Yousuf-Eslam/HELAL73_Robot/README.md

The project is documented in this video: https://www.youtube.com/watch?v=oLMEJUjaXHw&t=226s
