Yousuf-Eslam/HELAL73_Robot/Renders/Screenshot_1.png

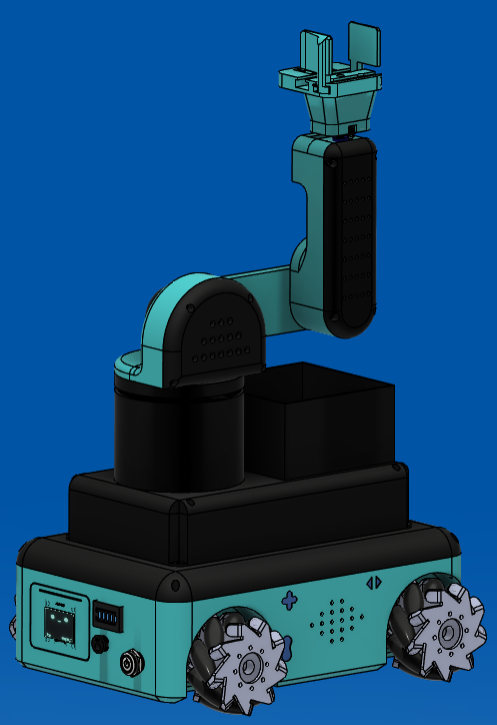
Renders/Screenshot_1.png
