Yousuf-Eslam/HELAL73_Robot/Renders/Screenshot_2.png

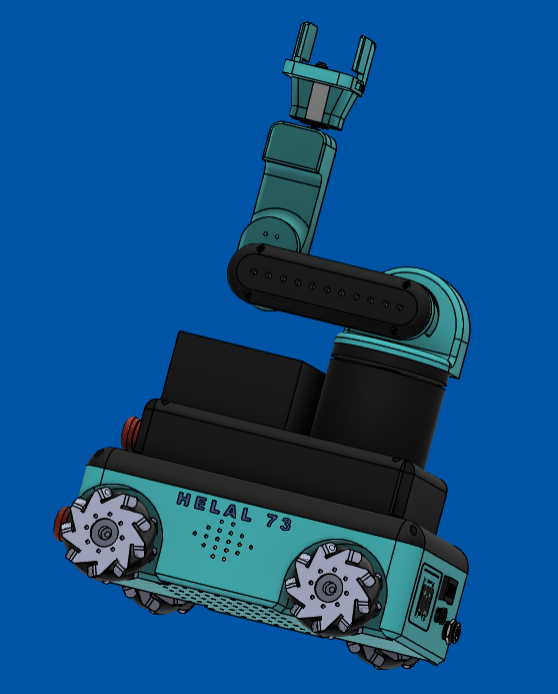
Renders/Screenshot_2.png
