Yousuf-Eslam/HELAL73_Robot/Renders/Screenshot_3.png

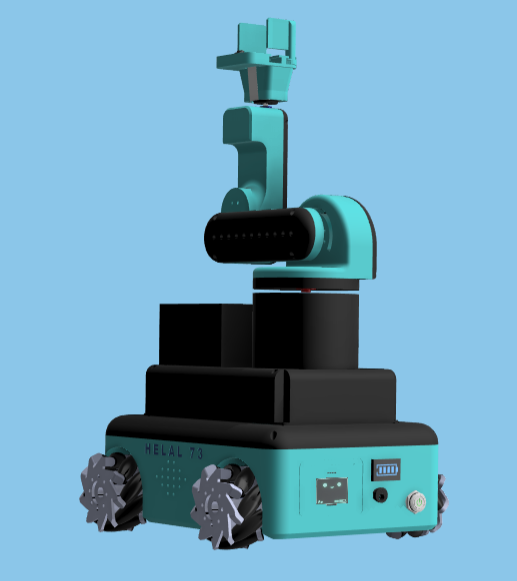
Renders/Screenshot_3.png
