Yousuf-Eslam/HELAL73_Robot/Renders/Screenshot_4.png

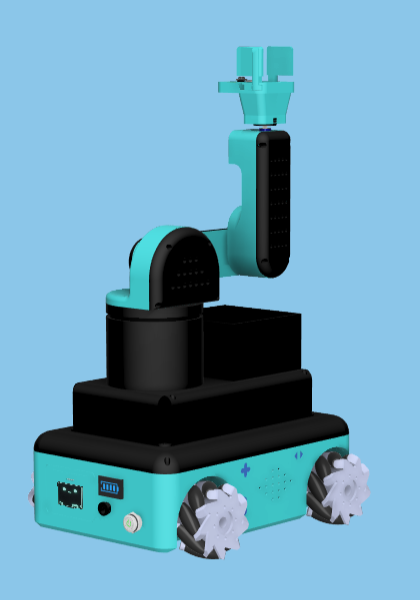
Renders/Screenshot_4.png
