Yousuf-Eslam/HELAL73_Robot/Renders/Screenshot_5.png

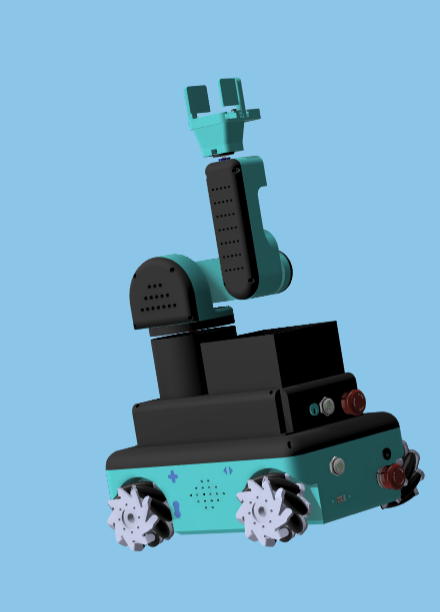
Renders/Screenshot_5.png
