Yousuf-Eslam/HELAL73_Robot/3D_Printing_Files/Exports 9-5/Main_Part.stl

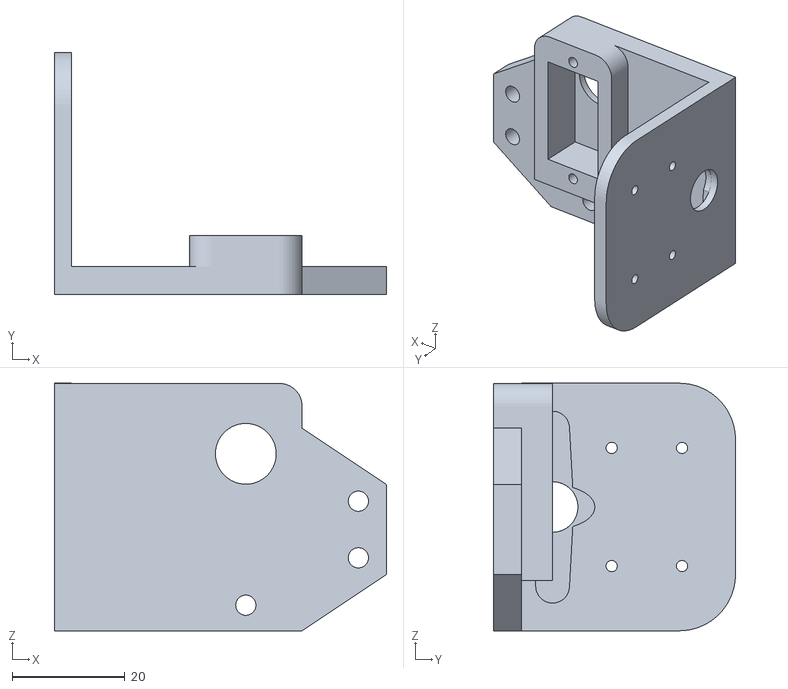
[picture p26: CAD file, 2026-09-05]
3D_Printing_Files/Exports 9-5/Main_Part.stl
59.0 x 43.0 x 44.0
