Yousuf-Eslam/HELAL73_Robot/Arm_URDF_Files/Gripper Assembly.step

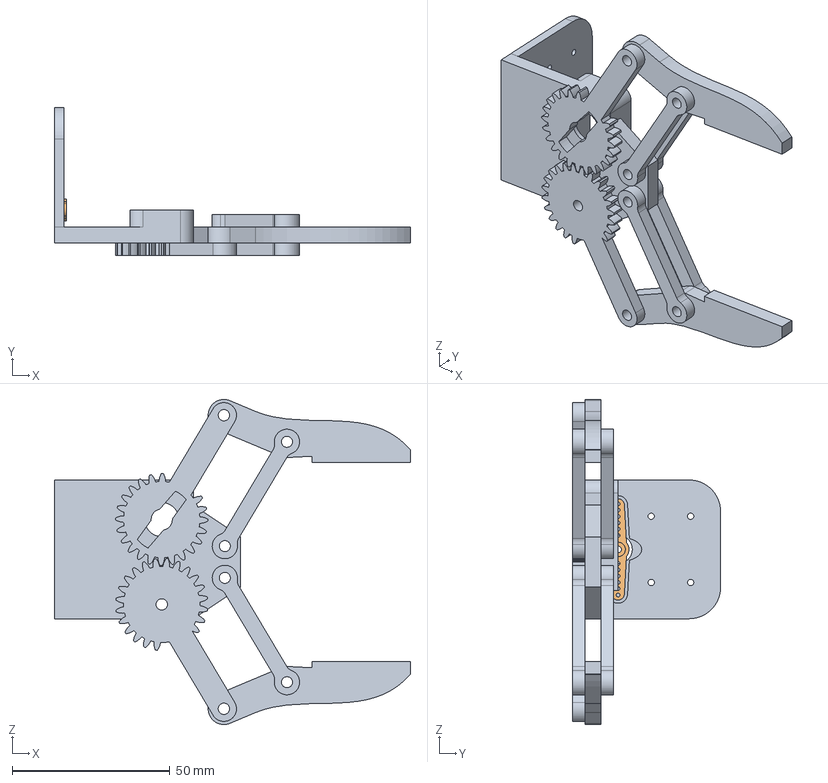
[picture p27: CAD file, 2026-09-05]
Arm_URDF_Files/Gripper Assembly.step
112.9 x 47.0 x 103.1 mm
