Yousuf-Eslam/HELAL73_Robot/3D_Printing_Files/Cover Sketch.dxf

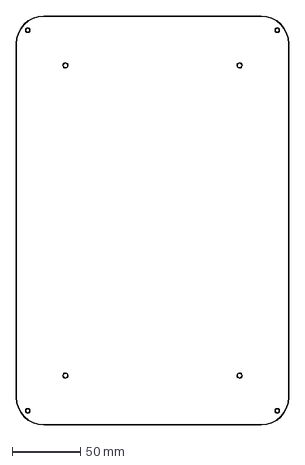
[picture p28: CAD file, 2026-09-05]
3D_Printing_Files/Cover Sketch.dxf
200.0 x 300.0 mm
