Yousuf-Eslam/HELAL73_Robot/3D_Printing_Files/Exports 18-4/Rover Body(Light Blue).stl

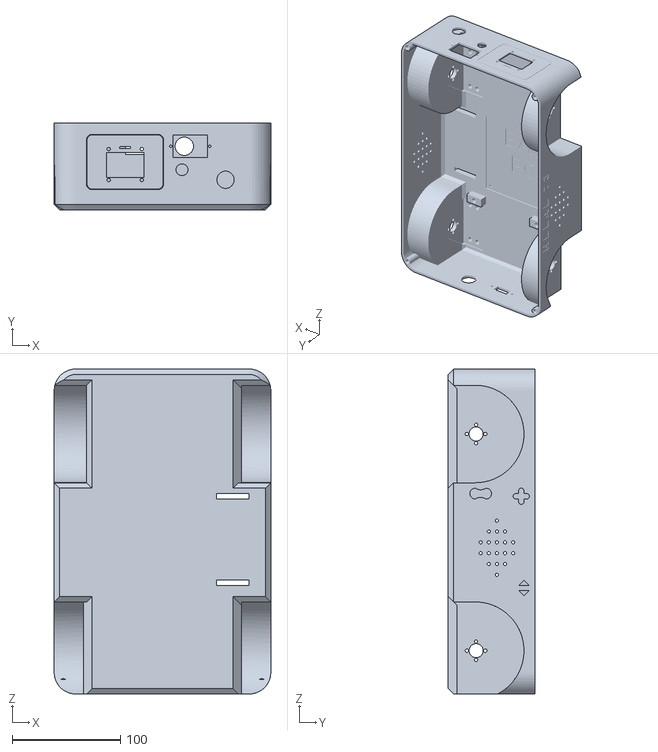
[picture p29: CAD file, 2026-09-05]
3D_Printing_Files/Exports 18-4/Rover Body(Light Blue).stl
200.0 x 80.0 x 300.0
