Yousuf-Eslam/HELAL73_Robot/3D_Printing_Files/Exports 21 -4/DC Motor Mount.stl

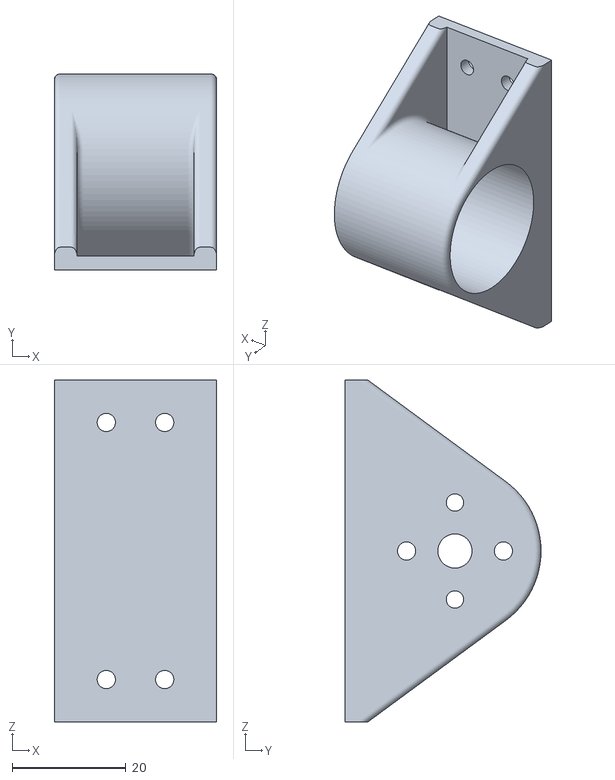
[picture p30: CAD file, 2026-09-05]
3D_Printing_Files/Exports 21 -4/DC Motor Mount.stl
28.5 x 34.4 x 60.0
