Yousuf-Eslam/HELAL73_Robot/3D_Printing_Files/Exports 7-5/Arm_Base_Joint_Connector_Modified.stl

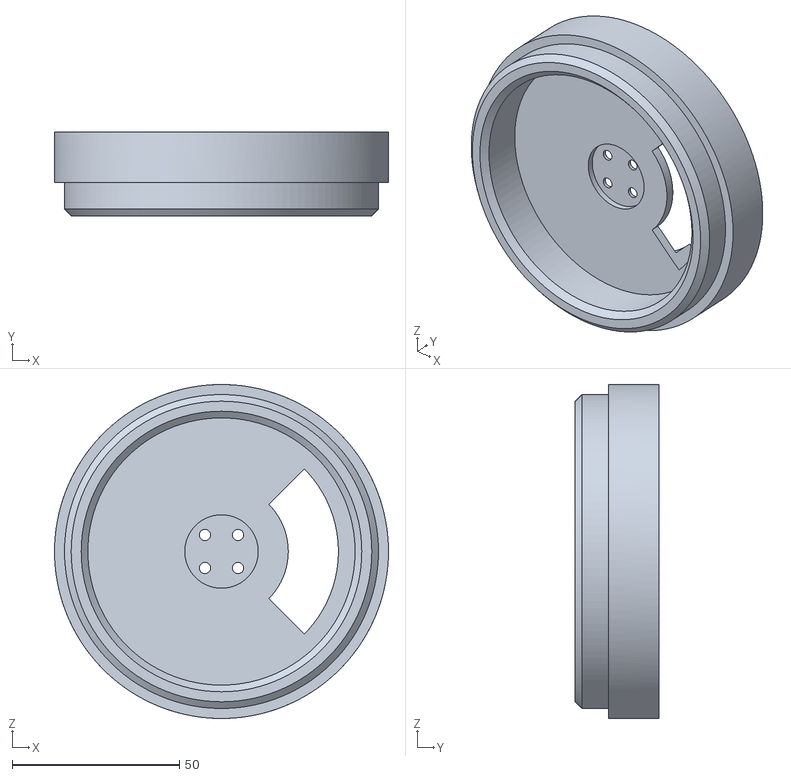
[picture p31: CAD file, 2026-09-05]
3D_Printing_Files/Exports 7-5/Arm_Base_Joint_Connector_Modified.stl
100.0 x 25.0 x 100.0
