Yousuf-Eslam/HELAL73_Robot/3D_Printing_Files/Exports 7-5/Gripper/Gear3.stl

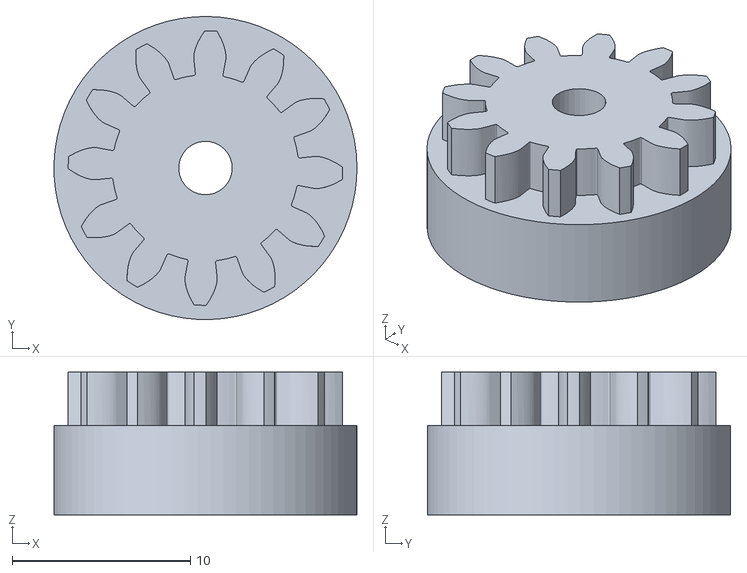
[picture p32: CAD file, 2026-09-05]
3D_Printing_Files/Exports 7-5/Gripper/Gear3.stl
17.0 x 17.0 x 8.00
