Yousuf-Eslam/HELAL73_Robot/3D_Printing_Files/Gripper/Grip Connector Step.stl

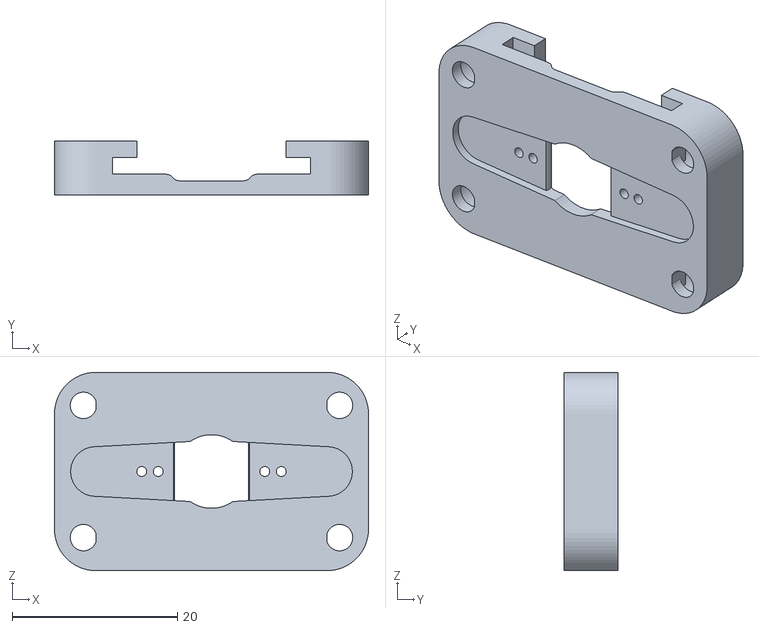
[picture p33: CAD file, 2026-09-05]
3D_Printing_Files/Gripper/Grip Connector Step.stl
38.0 x 6.50 x 24.0
