Yousuf-Eslam/HELAL73_Robot/3D_Printing_Files/Joints/Joint 3 Cover.step

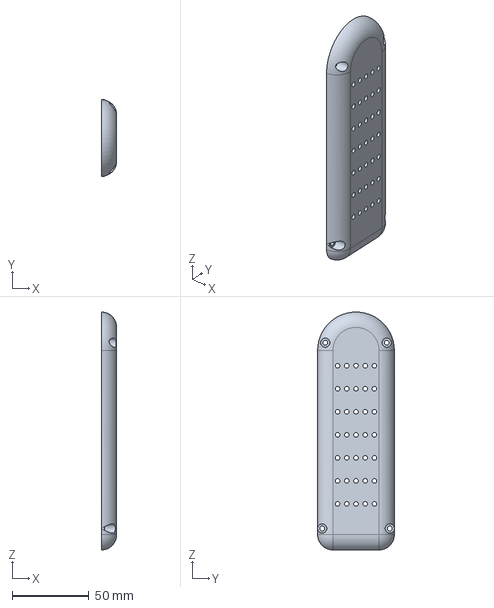
[picture p34: CAD file, 2026-09-05]
3D_Printing_Files/Joints/Joint 3 Cover.step
10.0 x 50.0 x 155.0 mm
