Yousuf-Eslam/HELAL73_Robot/3D_Printing_Files/STL Pack 2/Part 7 - Joint 1 Cover.stl

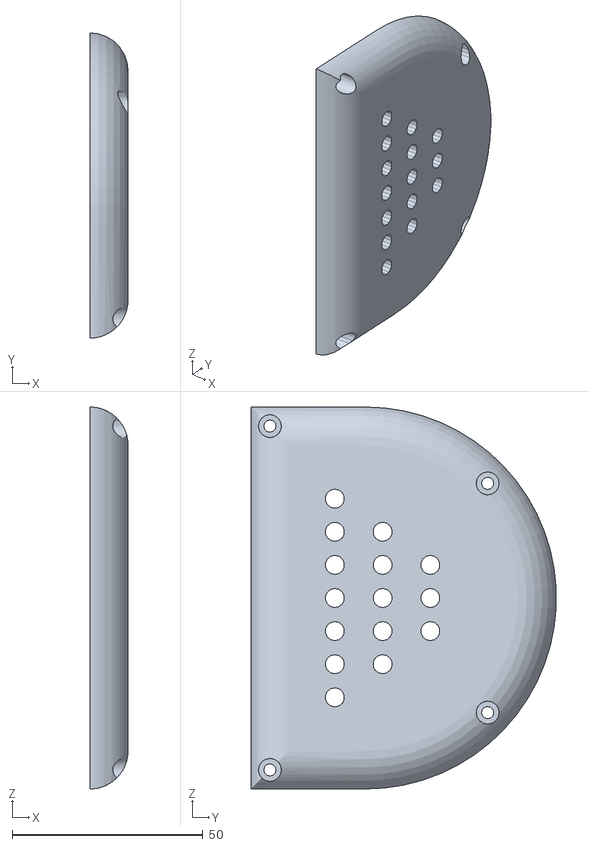
[picture p35: CAD file, 2026-09-05]
3D_Printing_Files/STL Pack 2/Part 7 - Joint 1 Cover.stl
10.0 x 79.9 x 100.0
