Yousuf-Eslam/HELAL73_Robot/Arm_URDF_Files/Beta_V7/Assembly.SLDASM/meshes/base_link.STL

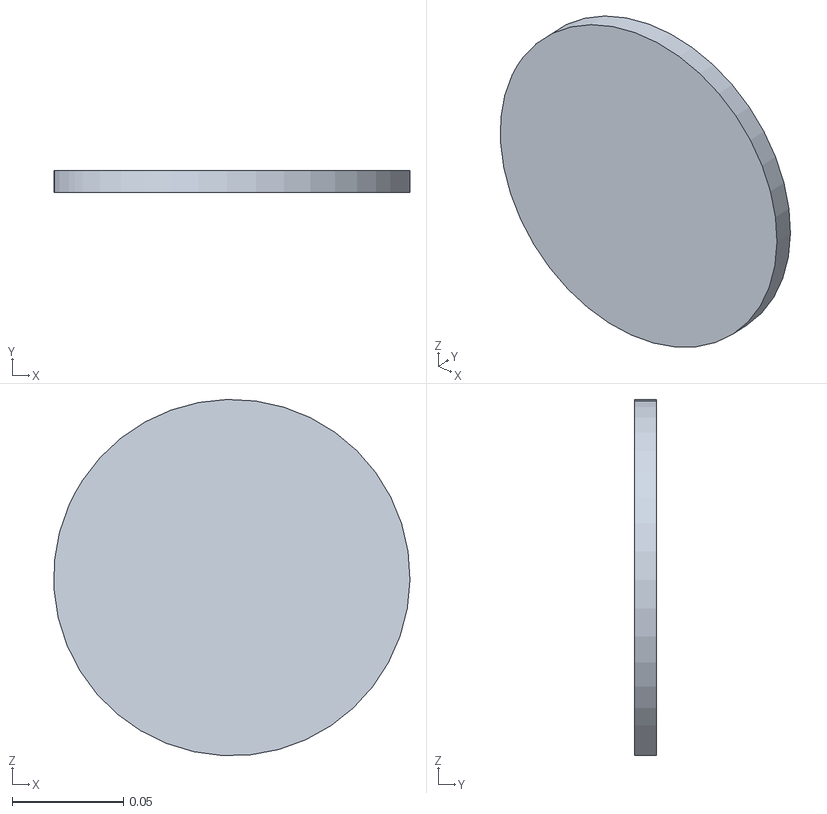
[picture p36: CAD file, 2026-09-05]
Arm_URDF_Files/Beta_V7/Assembly.SLDASM/meshes/base_link.STL
0.16 x 0.01 x 0.16
