Yousuf-Eslam/HELAL73_Robot/Arm_URDF_Files/Joint 3.step

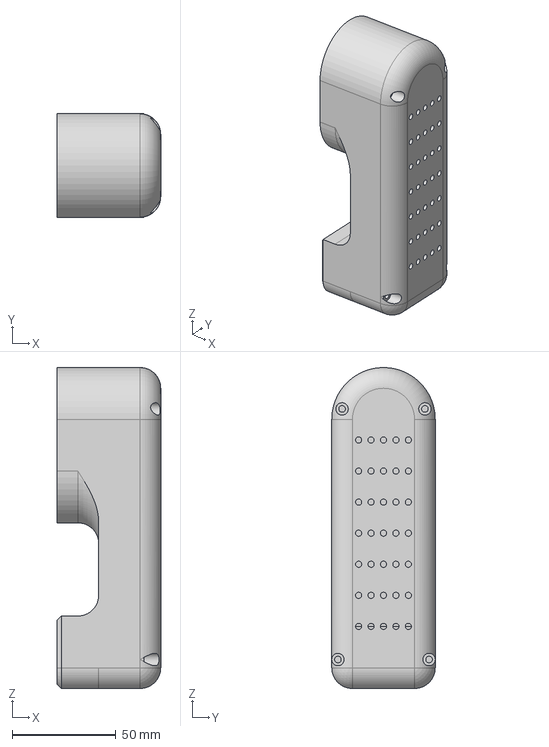
[picture p37: CAD file, 2026-09-05]
Arm_URDF_Files/Joint 3.step
50.0 x 50.0 x 155.0 mm
