Yousuf-Eslam/HELAL73_Robot/Arm_URDF_Files/URDF Assembly/Assembly.SLDASM/meshes/link1.STL

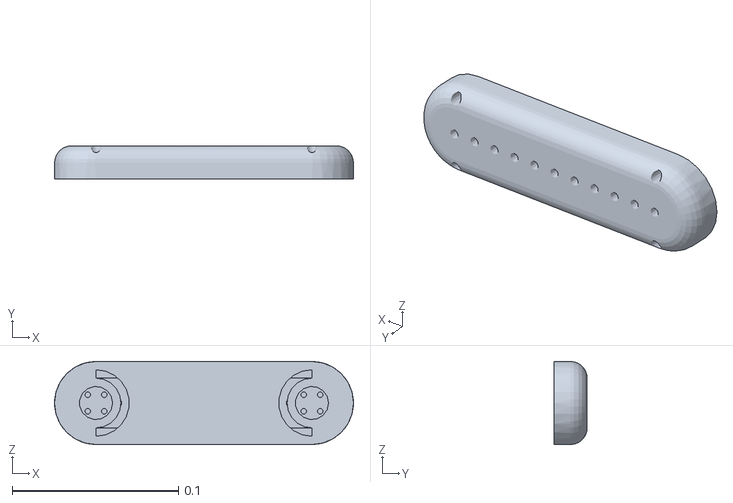
[picture p38: CAD file, 2026-09-05]
Arm_URDF_Files/URDF Assembly/Assembly.SLDASM/meshes/link1.STL
0.18 x 0.02 x 0.05
