Yousuf-Eslam/HELAL73_Robot/3D_Printing_Files/Exports 18-4/Big Gear(Light Blue).stl

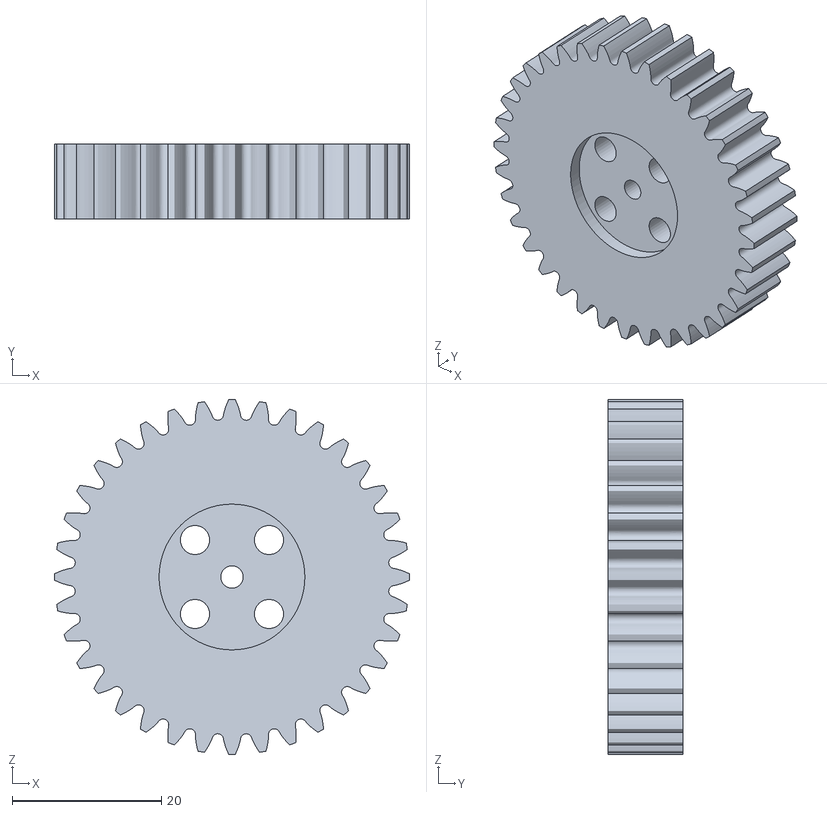
[picture p39: CAD file, 2026-09-05]
3D_Printing_Files/Exports 18-4/Big Gear(Light Blue).stl
47.5 x 10.0 x 47.5
