Yousuf-Eslam/HELAL73_Robot/3D_Printing_Files/Exports 7-5/Gripper/Gear2.stl

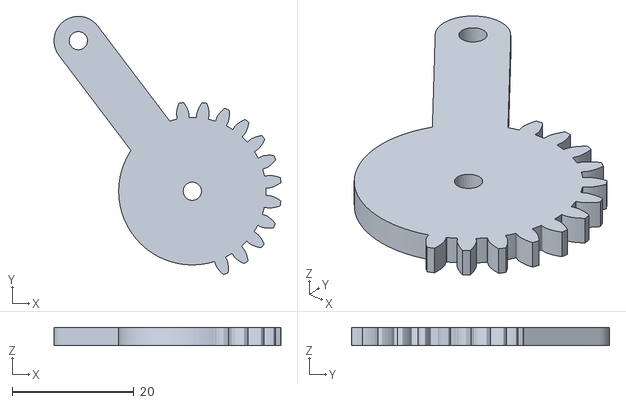
[picture p40: CAD file, 2026-09-05]
3D_Printing_Files/Exports 7-5/Gripper/Gear2.stl
37.3 x 42.4 x 3.00
