Yousuf-Eslam/HELAL73_Robot/3D_Printing_Files/Exports 9-5/Link(6 Times).stl

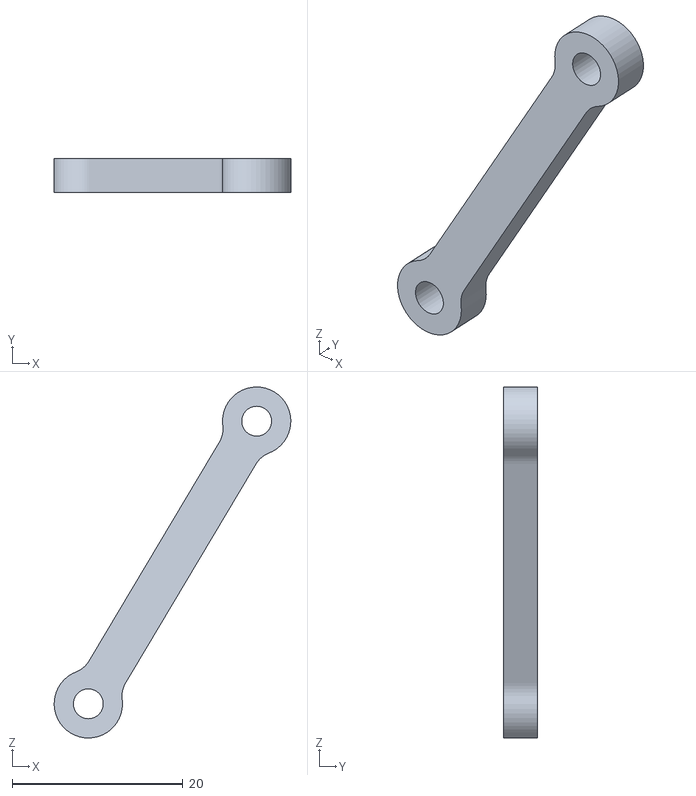
[picture p41: CAD file, 2026-09-05]
3D_Printing_Files/Exports 9-5/Link(6 Times).stl
27.7 x 4.00 x 41.1
