Yousuf-Eslam/HELAL73_Robot/3D_Printing_Files/Gripper/Gear.stl

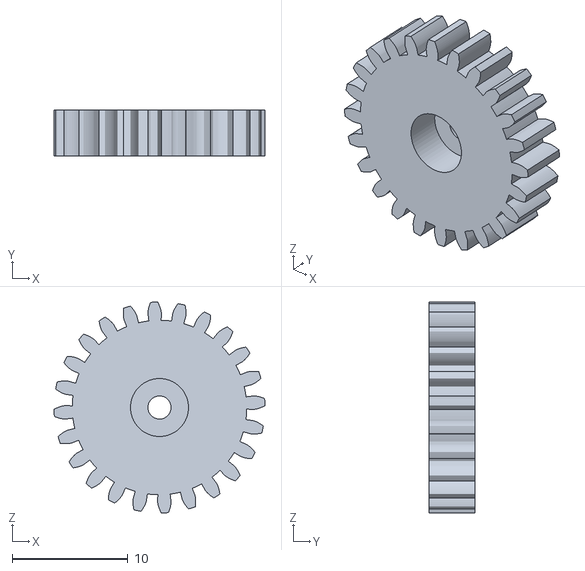
[picture p42: CAD file, 2026-09-05]
3D_Printing_Files/Gripper/Gear.stl
18.2 x 4.00 x 18.2
