Yousuf-Eslam/HELAL73_Robot/3D_Printing_Files/Joints/Joint1 Body.step

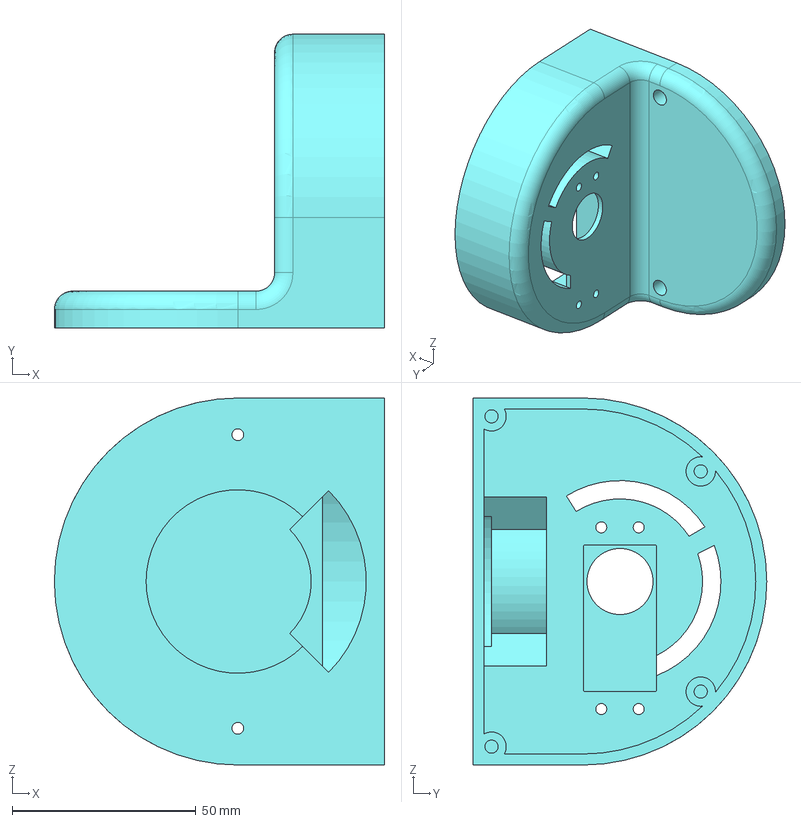
[picture p43: CAD file, 2026-09-05]
3D_Printing_Files/Joints/Joint1 Body.step
90.0 x 80.0 x 100.0 mm
