Yousuf-Eslam/HELAL73_Robot/3D_Printing_Files/Platform Container.step

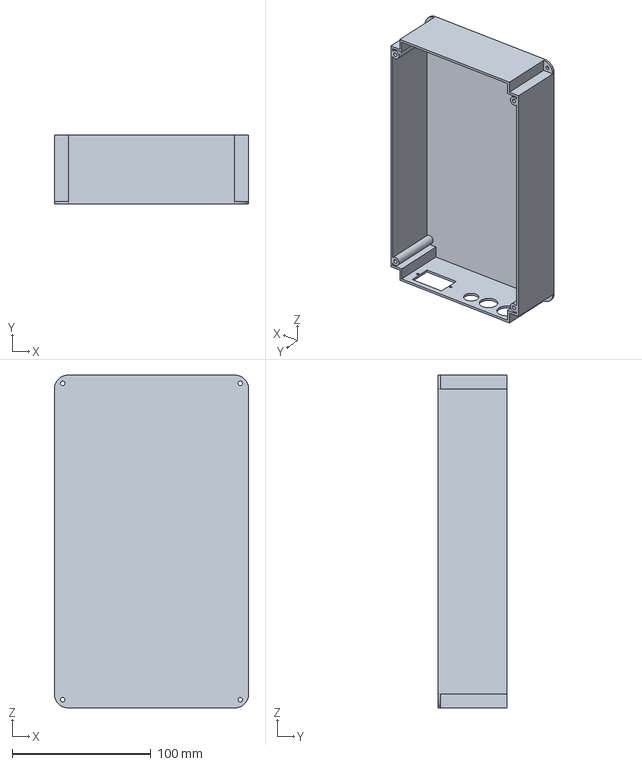
[picture p44: CAD file, 2026-09-05]
3D_Printing_Files/Platform Container.step
140.0 x 50.0 x 240.0 mm
