Yousuf-Eslam/HELAL73_Robot/3D_Printing_Files/STL Pack 1/Joint 3 Body.stl

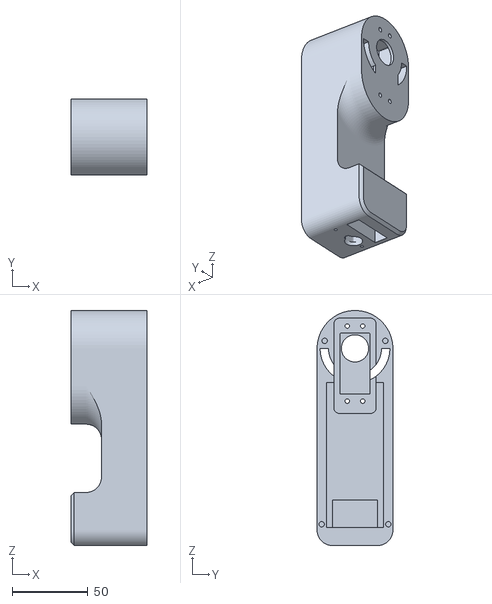
[picture p45: CAD file, 2026-09-05]
3D_Printing_Files/STL Pack 1/Joint 3 Body.stl
50.0 x 50.0 x 155.0
