Yousuf-Eslam/HELAL73_Robot/3D_Printing_Files/STL Pack 2/Part 2- Arm Motor Holder.stl

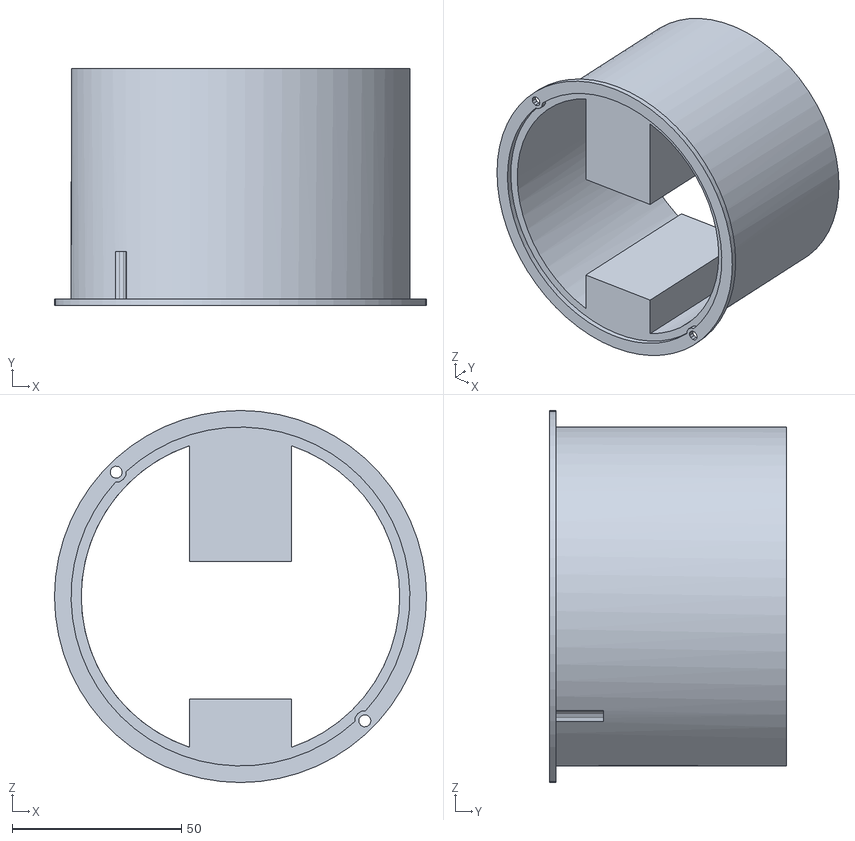
[picture p46: CAD file, 2026-09-05]
3D_Printing_Files/STL Pack 2/Part 2- Arm Motor Holder.stl
109.8 x 70.0 x 109.8
