Yousuf-Eslam/HELAL73_Robot/Arm_URDF_Files/Gripper.step

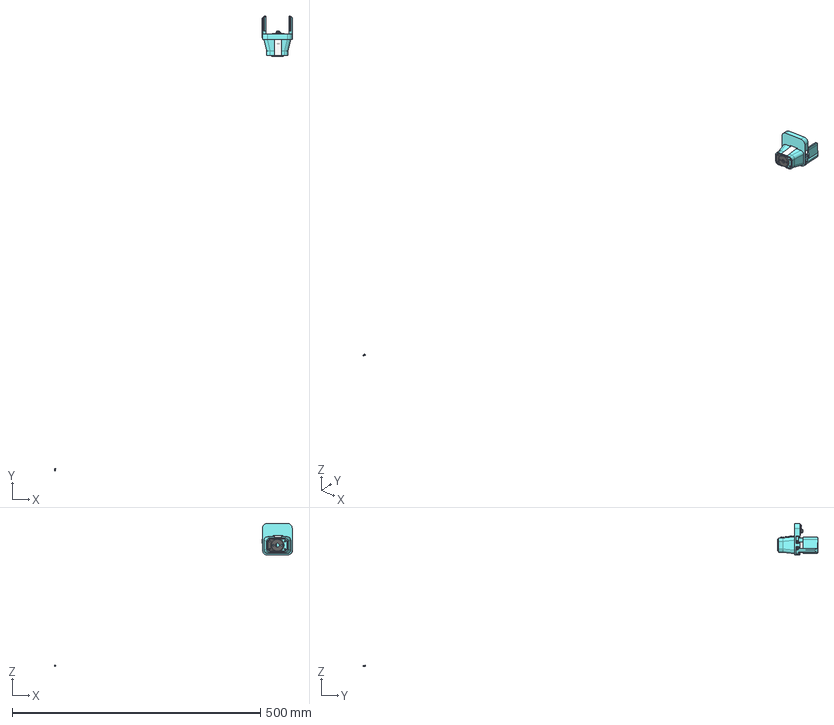
[picture p47: CAD file, 2026-09-05]
Arm_URDF_Files/Gripper.step
480.0 x 915.9 x 288.5 mm
gripper_rail_base
SG90 - Micro Servo 9g - Tower Pro.1_Pea
SG90 - Micro Servo 9g - Tower Pro.6_BS EN ISO 7045 - M2 x 4 - Z - 4S
gripper_spur_gear
gripper_finger x 2
gripper_base_plate
hex_socket_button_head_M3x35 x 4
insert_M3_D5_L5 x 4
angle_sensor_holder_wrist
Cam V2.1
