Yousuf-Eslam/HELAL73_Robot/Arm_URDF_Files/URDF Assembly/Assembly.SLDASM/meshes/Empty_Link.STL

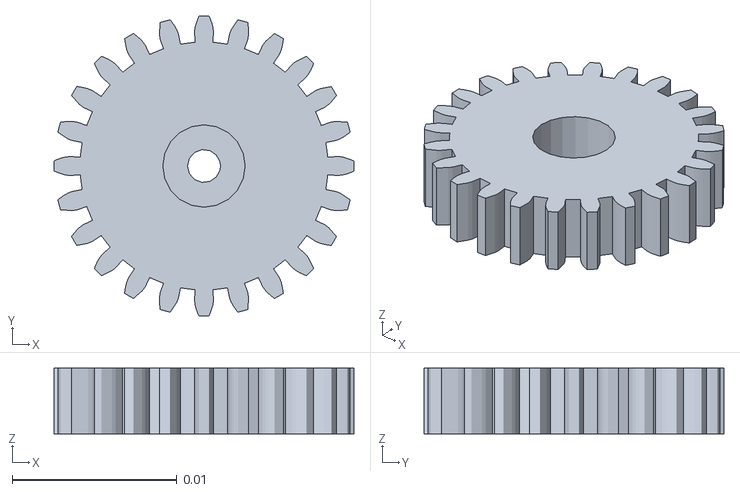
[picture p48: CAD file, 2026-09-05]
Arm_URDF_Files/URDF Assembly/Assembly.SLDASM/meshes/Empty_Link.STL
0.0182 x 0.0182 x 0.004
