Yousuf-Eslam/HELAL73_Robot/3D_Printing_Files/Exports 18-4/Gear Box Wall(Black).stl

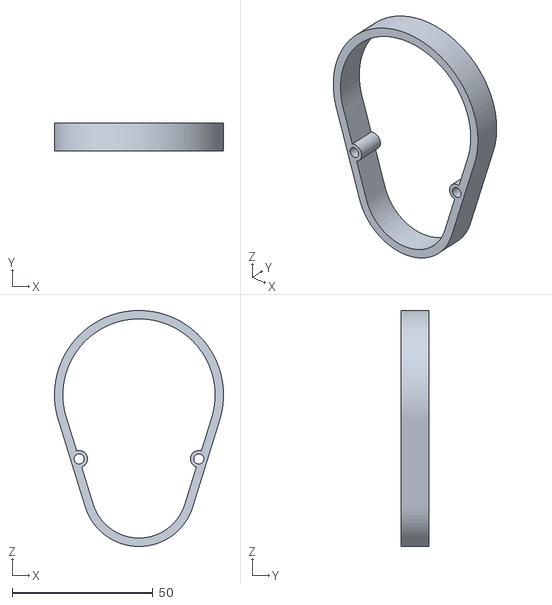
[picture p49: CAD file, 2026-09-05]
3D_Printing_Files/Exports 18-4/Gear Box Wall(Black).stl
60.0 x 10.0 x 83.7
