Yousuf-Eslam/HELAL73_Robot/3D_Printing_Files/Exports 7-5/Gripper/Finger(4 Times).stl

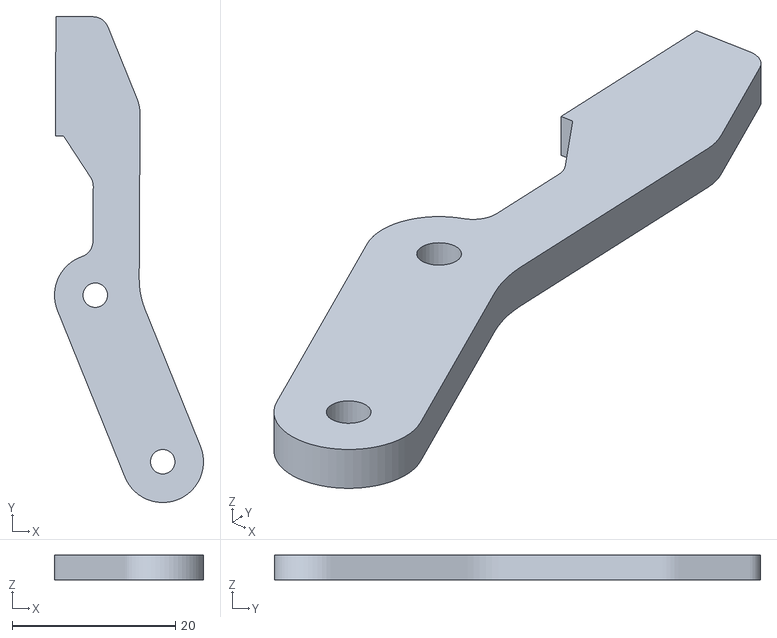
[picture p50: CAD file, 2026-09-05]
3D_Printing_Files/Exports 7-5/Gripper/Finger(4 Times).stl
18.2 x 59.5 x 3.00
