Yousuf-Eslam/HELAL73_Robot/3D_Printing_Files/Exports 9-5/Finger2.stl

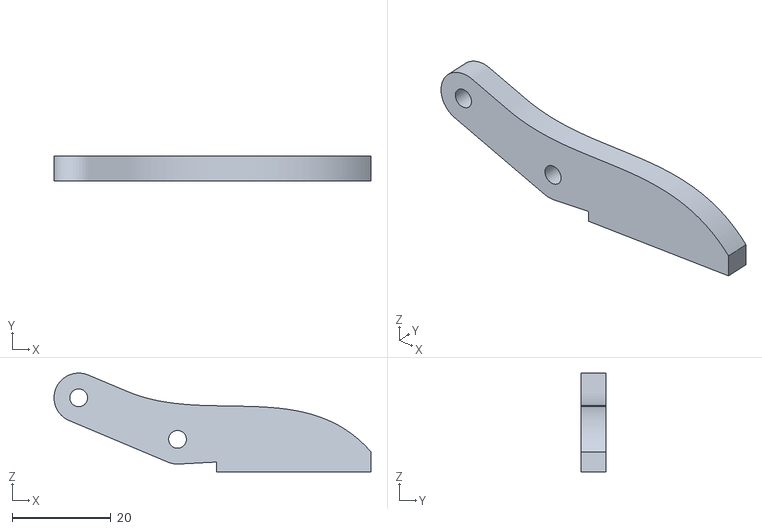
[picture p51: CAD file, 2026-09-05]
3D_Printing_Files/Exports 9-5/Finger2.stl
64.2 x 5.00 x 20.0
