Yousuf-Eslam/HELAL73_Robot/3D_Printing_Files/Joints/Joint 2 Body.step

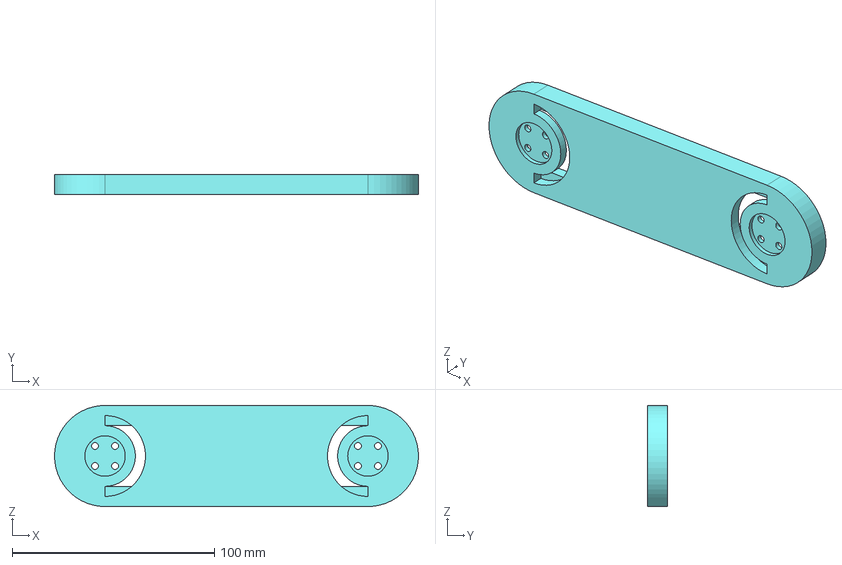
[picture p52: CAD file, 2026-09-05]
3D_Printing_Files/Joints/Joint 2 Body.step
180.0 x 10.0 x 50.0 mm
