Yousuf-Eslam/HELAL73_Robot/3D_Printing_Files/STL Pack 2/Part 8 -Joint 2 Cover.stl

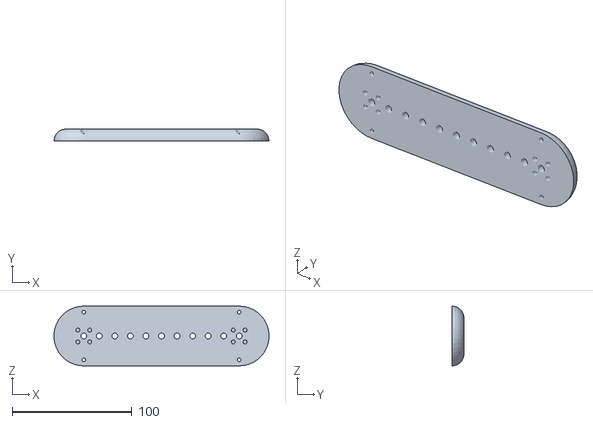
[picture p53: CAD file, 2026-09-05]
3D_Printing_Files/STL Pack 2/Part 8 -Joint 2 Cover.stl
179.8 x 10.0 x 50.0
