Yousuf-Eslam/HELAL73_Robot/Arm_URDF_Files/Joint 2.step

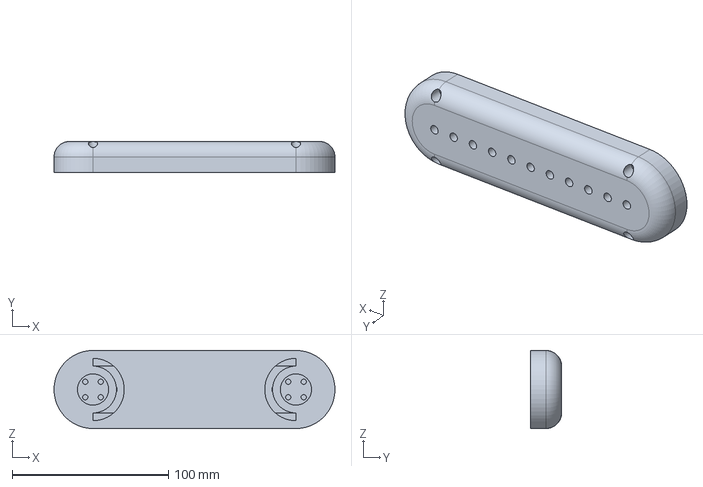
[picture p54: CAD file, 2026-09-05]
Arm_URDF_Files/Joint 2.step
180.0 x 20.0 x 50.0 mm
