Yousuf-Eslam/HELAL73_Robot/Arm_URDF_Files/URDF Assembly/Assembly.SLDASM/meshes/link2.STL

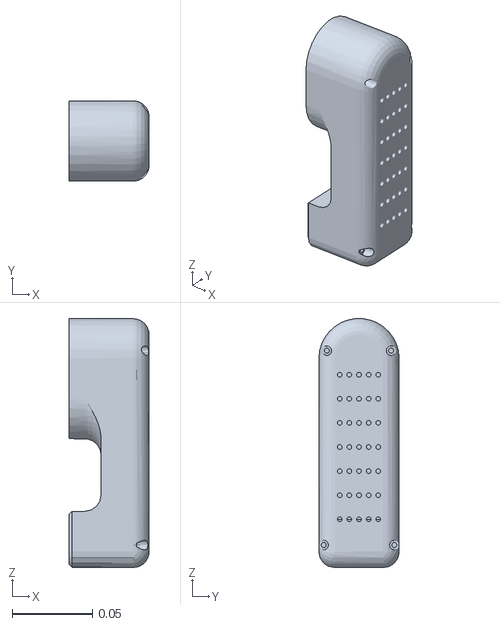
[picture p55: CAD file, 2026-09-05]
Arm_URDF_Files/URDF Assembly/Assembly.SLDASM/meshes/link2.STL
0.05 x 0.05 x 0.155
