Yousuf-Eslam/HELAL73_Robot/3D_Printing_Files/Car Cover.step

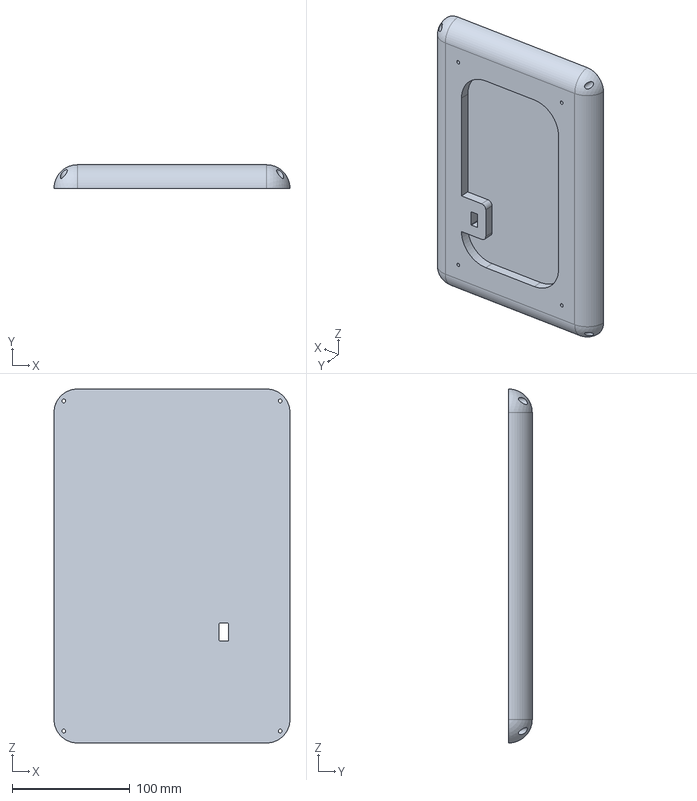
[picture p56: CAD file, 2026-09-05]
3D_Printing_Files/Car Cover.step
200.0 x 20.0 x 300.0 mm
