Yousuf-Eslam/HELAL73_Robot/3D_Printing_Files/Exports 18-4/Arm Container(Black).stl

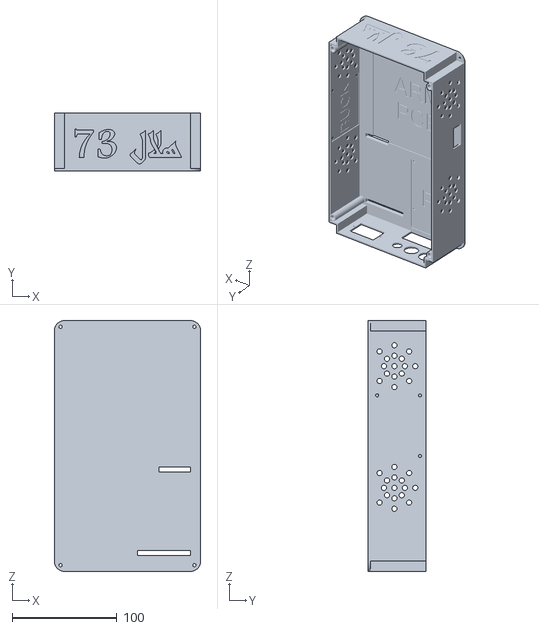
[picture p57: CAD file, 2026-09-05]
3D_Printing_Files/Exports 18-4/Arm Container(Black).stl
140.0 x 55.0 x 240.0
