Yousuf-Eslam/HELAL73_Robot/3D_Printing_Files/Exports 7-5/Gripper/Profile(2Times).stl

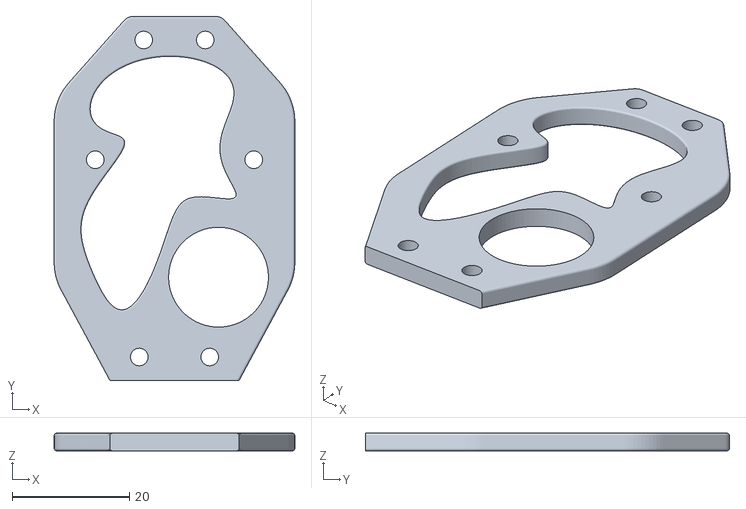
[picture p58: CAD file, 2026-09-05]
3D_Printing_Files/Exports 7-5/Gripper/Profile(2Times).stl
41.0 x 62.0 x 3.00
