Yousuf-Eslam/HELAL73_Robot/3D_Printing_Files/Exports 9-5/Gear1.stl

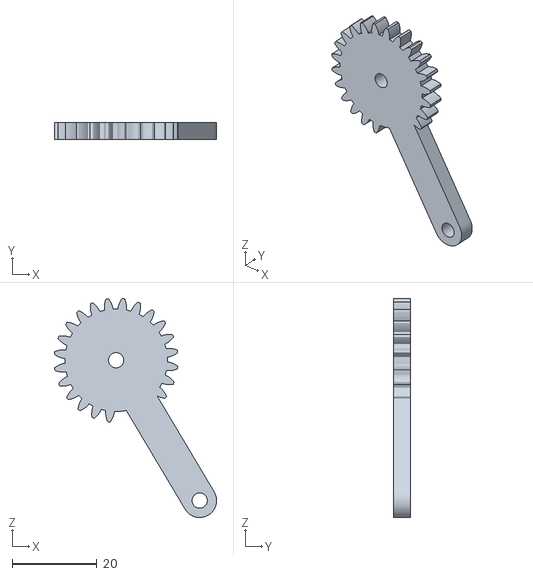
[picture p59: CAD file, 2026-09-05]
3D_Printing_Files/Exports 9-5/Gear1.stl
38.3 x 4.00 x 51.6
