Yousuf-Eslam/HELAL73_Robot/3D_Printing_Files/STL Pack 1/Joint 1 Body.stl

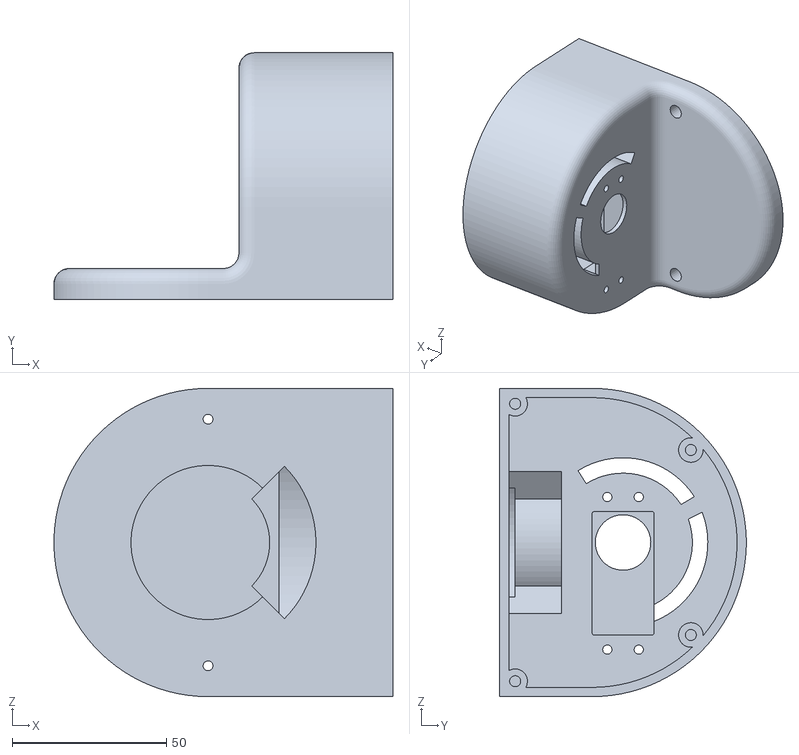
[picture p60: CAD file, 2026-09-05]
3D_Printing_Files/STL Pack 1/Joint 1 Body.stl
110.0 x 80.0 x 100.0
