Yousuf-Eslam/HELAL73_Robot/Arm_URDF_Files/Joint 1 - Simplified.step

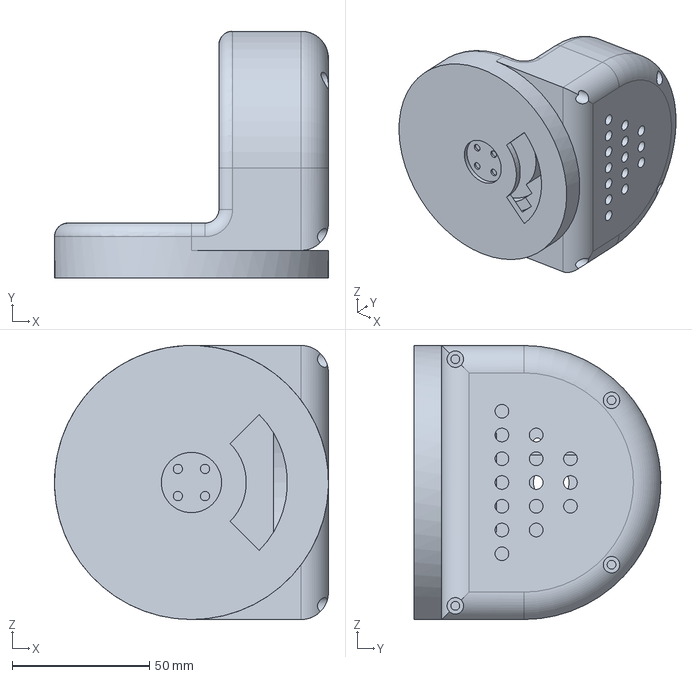
[picture p61: CAD file, 2026-09-05]
Arm_URDF_Files/Joint 1 - Simplified.step
100.0 x 90.0 x 100.0 mm
