Yousuf-Eslam/HELAL73_Robot/Arm_URDF_Files/URDF Assembly/Assembly.SLDASM/meshes/Wrist.STL

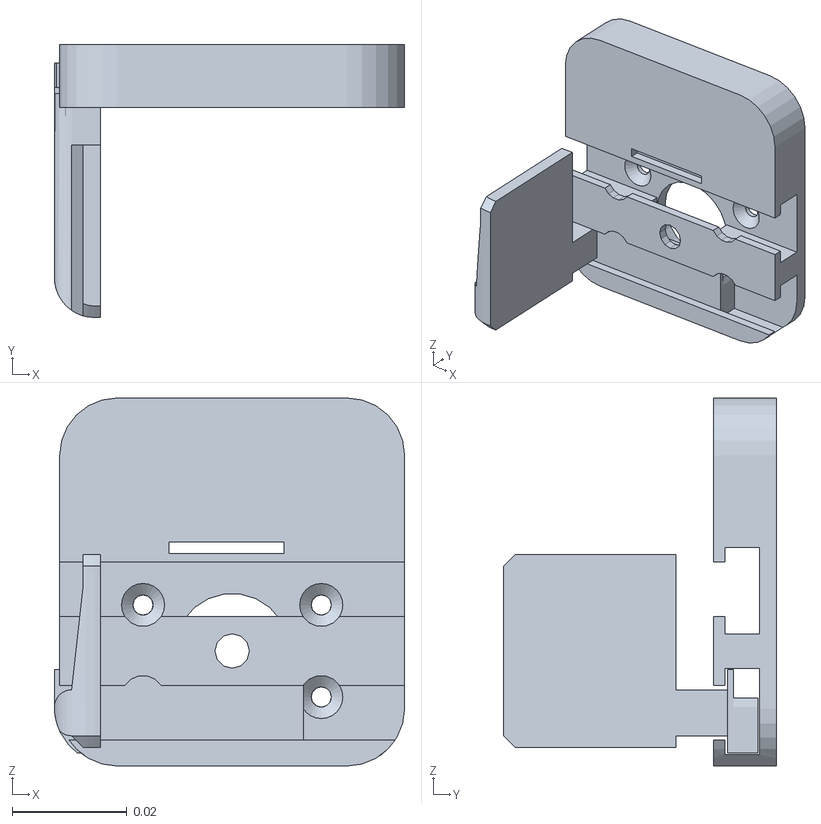
[picture p62: CAD file, 2026-09-05]
Arm_URDF_Files/URDF Assembly/Assembly.SLDASM/meshes/Wrist.STL
0.0609 x 0.0475 x 0.064
