Yousuf-Eslam/HELAL73_Robot/3D_Printing_Files/block.stl

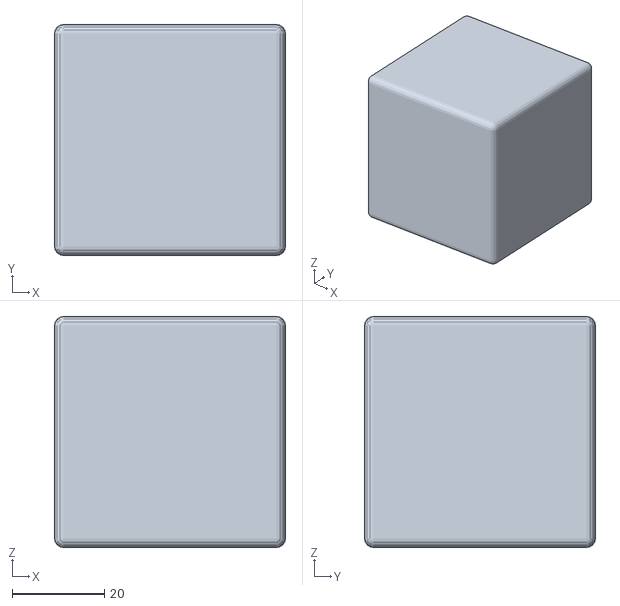
[picture p63: CAD file, 2026-09-05]
3D_Printing_Files/block.stl
50.0 x 50.0 x 50.0
