Yousuf-Eslam/HELAL73_Robot/3D_Printing_Files/Exports 18-4/Small Gear(Light Blue).stl

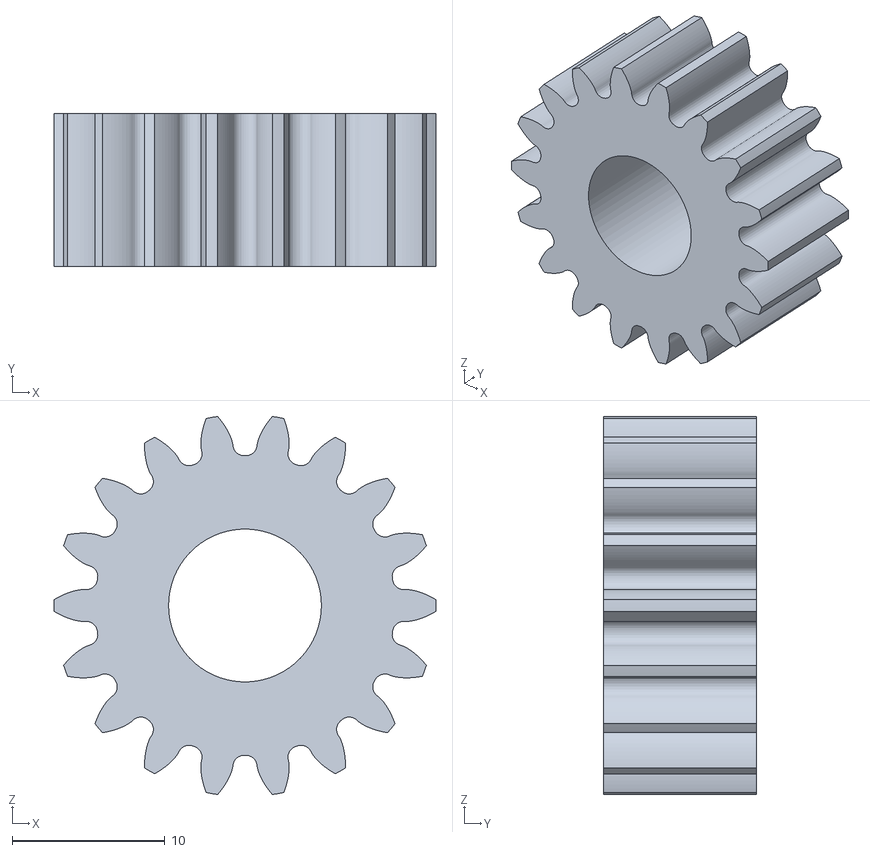
[picture p64: CAD file, 2026-09-05]
3D_Printing_Files/Exports 18-4/Small Gear(Light Blue).stl
25.0 x 10.0 x 24.7
