Yousuf-Eslam/HELAL73_Robot/3D_Printing_Files/STL Pack 2/Part 6 -Joint 1 Bracket.stl

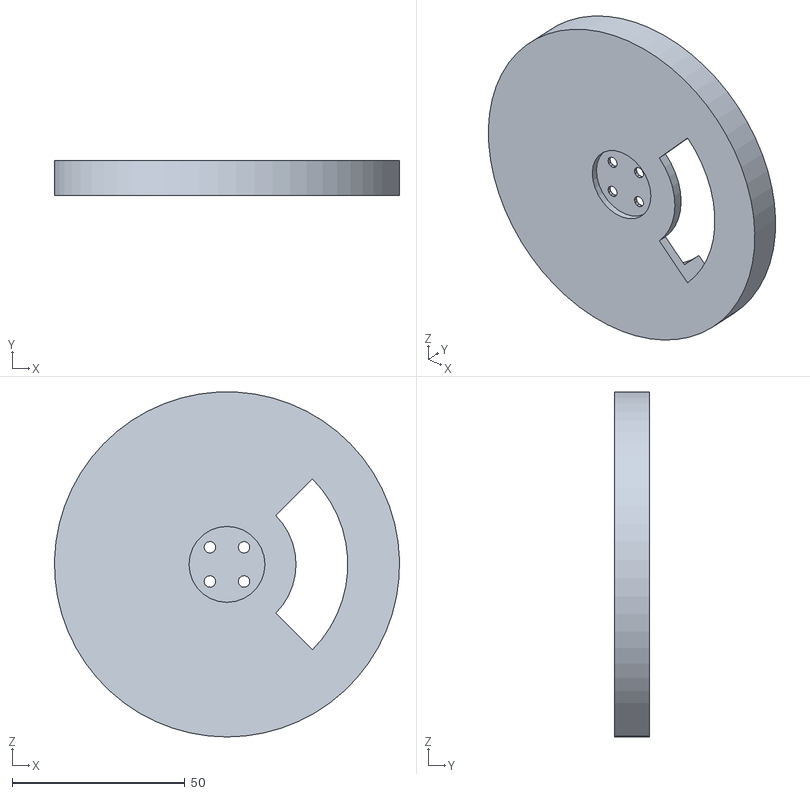
[picture p66: CAD file, 2026-09-05]
3D_Printing_Files/STL Pack 2/Part 6 -Joint 1 Bracket.stl
100.0 x 10.0 x 99.9
