Yousuf-Eslam/HELAL73_Robot/Arm_URDF_Files/URDF Assembly/Assembly.SLDASM/meshes/base_link.STL

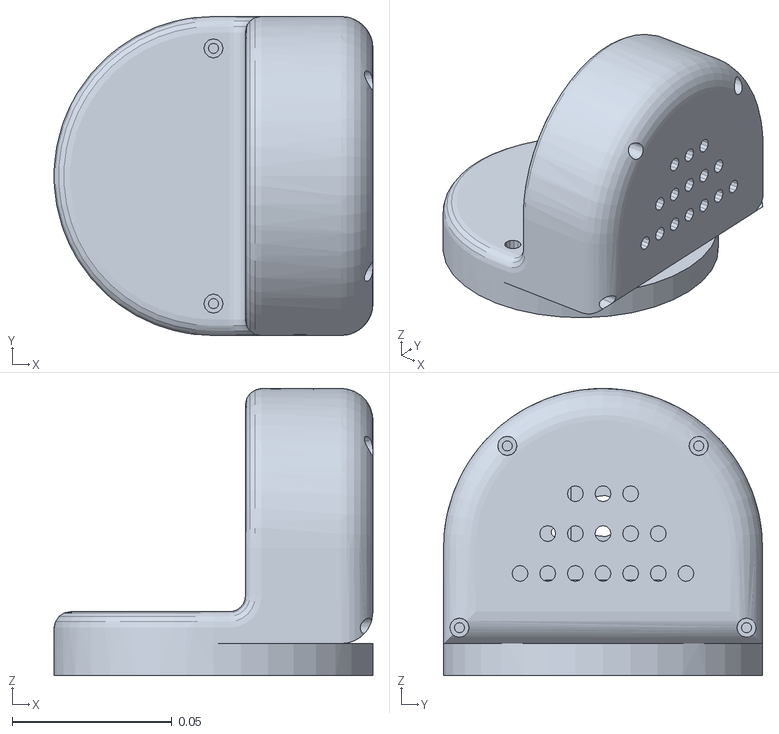
[picture p67: CAD file, 2026-09-05]
Arm_URDF_Files/URDF Assembly/Assembly.SLDASM/meshes/base_link.STL
0.1 x 0.1 x 0.09
