Yousuf-Eslam/HELAL73_Robot/3D_Printing_Files/Exports 18-4/Gear Box Holder(Black).stl

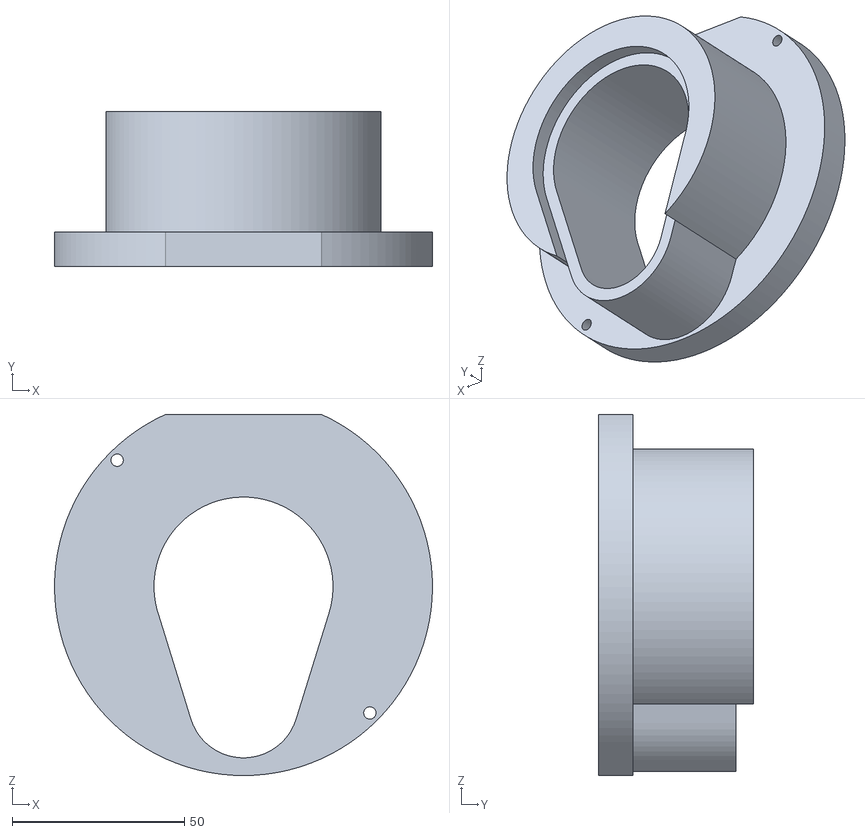
[picture p68: CAD file, 2026-09-05]
3D_Printing_Files/Exports 18-4/Gear Box Holder(Black).stl
109.8 x 45.0 x 104.9
