Yousuf-Eslam/HELAL73_Robot/3D_Printing_Files/Exports 7-5/Gripper/Link(8Times).stl

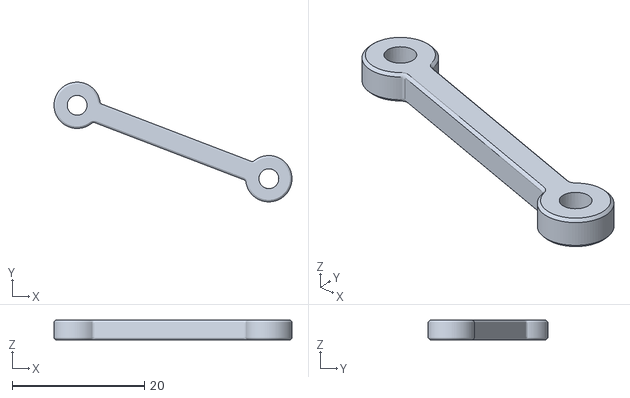
[picture p69: CAD file, 2026-09-05]
3D_Printing_Files/Exports 7-5/Gripper/Link(8Times).stl
35.9 x 18.1 x 3.00
