Yousuf-Eslam/HELAL73_Robot/3D_Printing_Files/HILAL 73 - Bin.stl

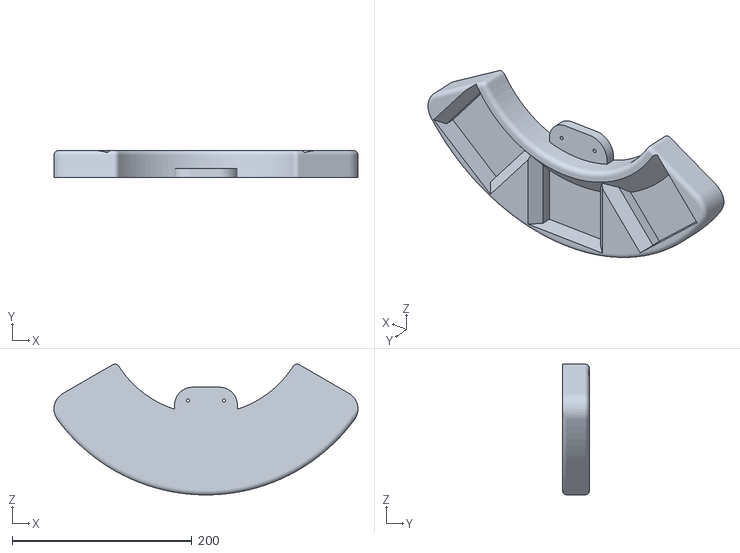
[picture p70: CAD file, 2026-09-05]
3D_Printing_Files/HILAL 73 - Bin.stl
338.5 x 30.0 x 145.7
