Yousuf-Eslam/HELAL73_Robot/3D_Printing_Files/Exports 18-4/Gear Box(Light Blue).stl

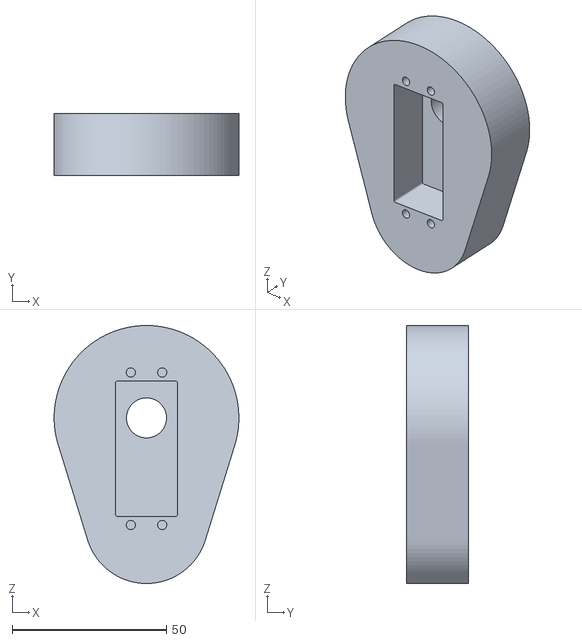
[picture p71: CAD file, 2026-09-05]
3D_Printing_Files/Exports 18-4/Gear Box(Light Blue).stl
60.0 x 20.0 x 83.7
