Yousuf-Eslam/HELAL73_Robot/3D_Printing_Files/Exports 7-5/Gripper/Bracket(2 Times).stl

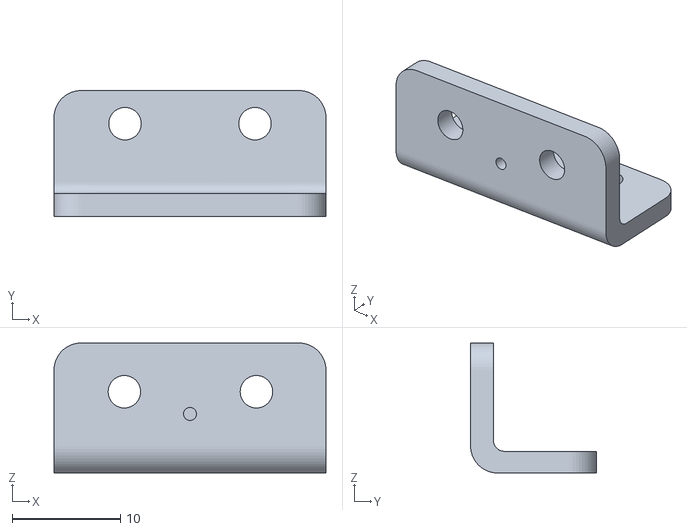
[picture p72: CAD file, 2026-09-05]
3D_Printing_Files/Exports 7-5/Gripper/Bracket(2 Times).stl
25.1 x 11.6 x 12.0
