Yousuf-Eslam/HELAL73_Robot/3D_Printing_Files/STL Pack 2/Part 5 - Joint 3 Cover.stl

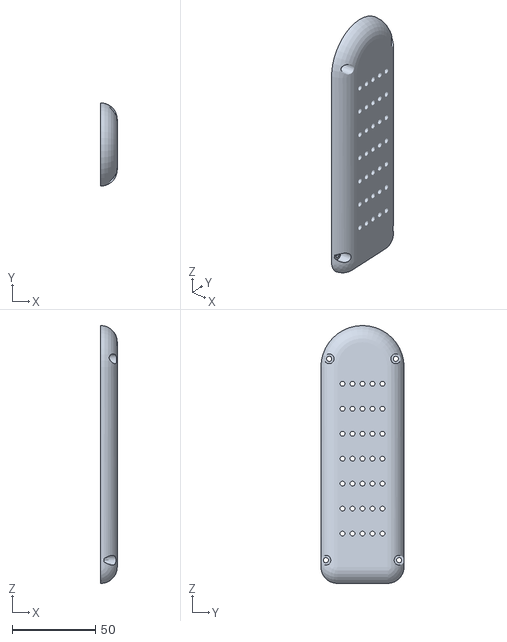
[picture p73: CAD file, 2026-09-05]
3D_Printing_Files/STL Pack 2/Part 5 - Joint 3 Cover.stl
10.0 x 50.0 x 155.0
