Yousuf-Eslam/HELAL73_Robot/3D_Printing_Files/v3_Mecanum Coupler.stl

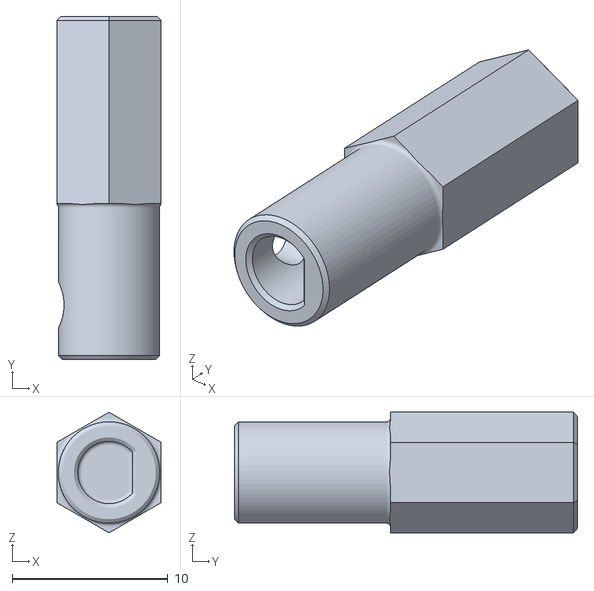
[picture p74: CAD file, 2026-09-05]
3D_Printing_Files/v3_Mecanum Coupler.stl
6.70 x 22.0 x 7.74
