Yousuf-Eslam/HELAL73_Robot/3D_Printing_Files/Exports 7-5/Gripper/Gear 1.stl

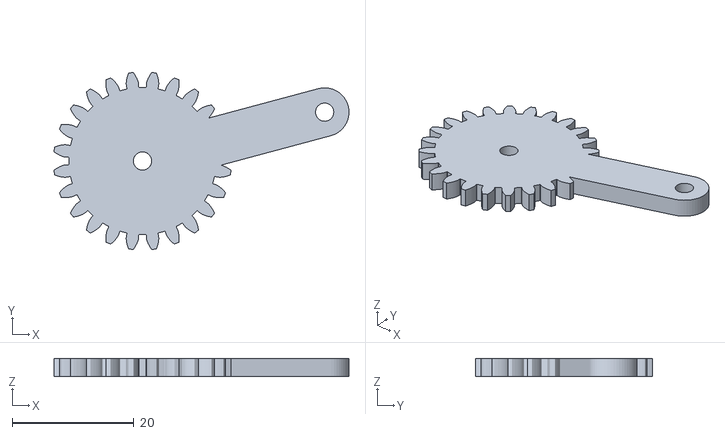
[picture p75: CAD file, 2026-09-05]
3D_Printing_Files/Exports 7-5/Gripper/Gear 1.stl
48.5 x 29.1 x 3.00
