Yousuf-Eslam/HELAL73_Robot/3D_Printing_Files/Plate DXF.dxf

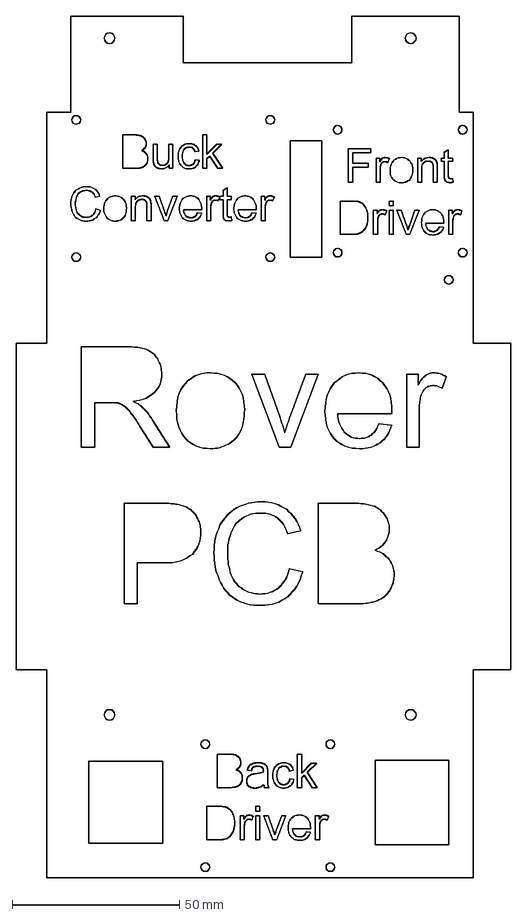
[picture p76: CAD file, 2026-09-05]
3D_Printing_Files/Plate DXF.dxf
147.8 x 257.5 mm
