Yousuf-Eslam/HELAL73_Robot/3D_Printing_Files/STL Pack 2/Part 3 - Arm Cover.stl

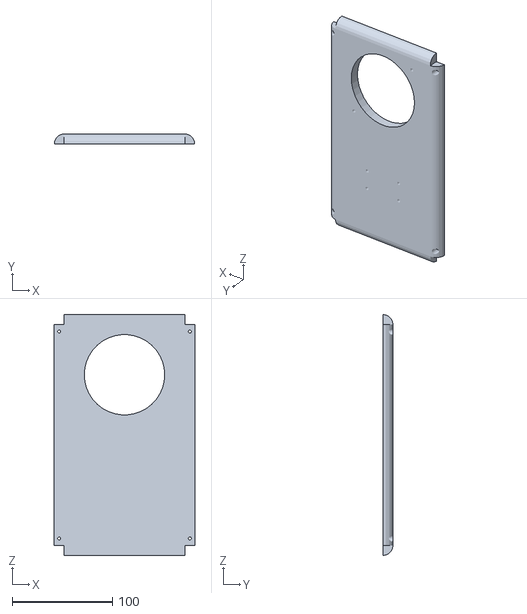
[picture p77: CAD file, 2026-09-05]
3D_Printing_Files/STL Pack 2/Part 3 - Arm Cover.stl
140.0 x 10.0 x 240.0
