Yousuf-Eslam/HELAL73_Robot/3D_Printing_Files/Cyan Parts.3mf

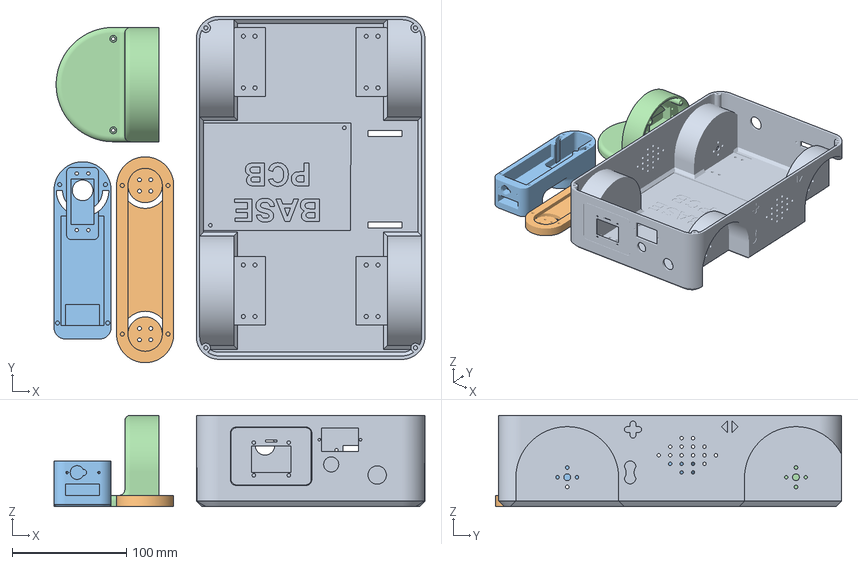
[picture p78: CAD file, 2026-09-05]
3D_Printing_Files/Cyan Parts.3mf
324.4 x 302.9 x 80.0 mm
Car Body.step
Joint 2 Body.step
Joint 3 Body.step
Joint1 Body.step
