Yousuf-Eslam/HELAL73_Robot/3D_Printing_Files/Joints/Joint 3 Body.step

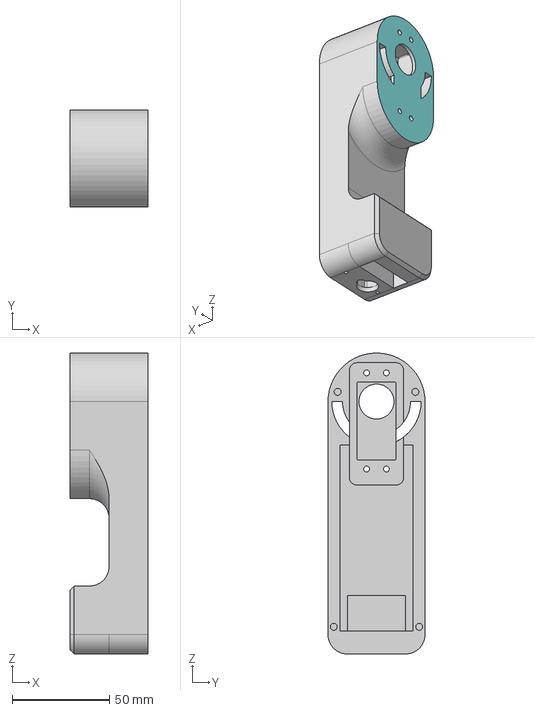
[picture p79: CAD file, 2026-09-05]
3D_Printing_Files/Joints/Joint 3 Body.step
40.0 x 50.0 x 155.0 mm
