Yousuf-Eslam/HELAL73_Robot/3D_Printing_Files/Platform Cover.step

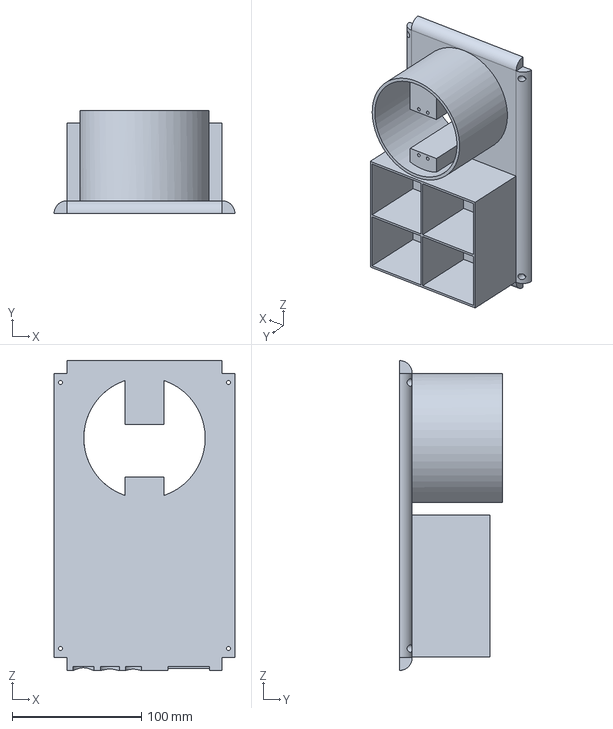
[picture p80: CAD file, 2026-09-05]
3D_Printing_Files/Platform Cover.step
140.0 x 80.0 x 240.0 mm
