Yousuf-Eslam/HELAL73_Robot/3D_Printing_Files/Mecanum Coupler.stl

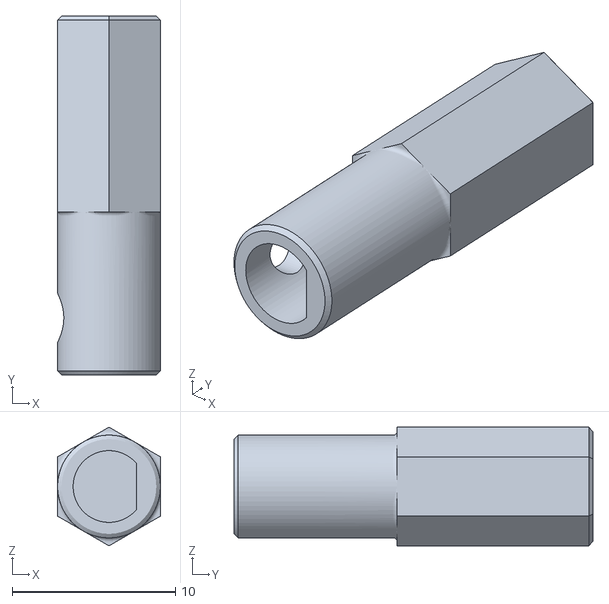
[picture p81: CAD file, 2026-09-05]
3D_Printing_Files/Mecanum Coupler.stl
6.30 x 22.0 x 7.27
