Yousuf-Eslam/HELAL73_Robot/Arm_URDF_Files/Assembly.SLDASM

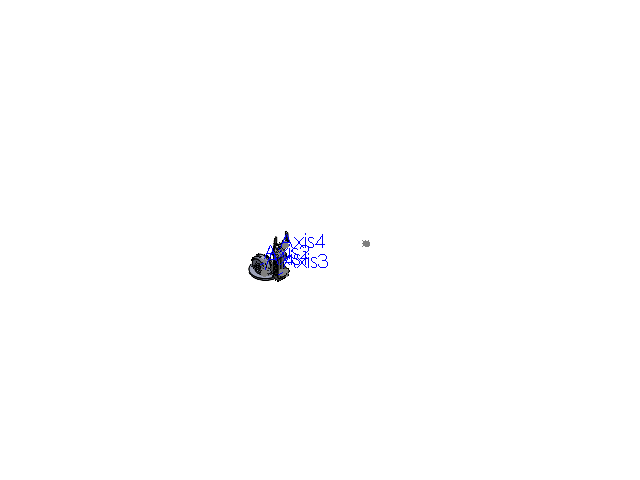
[picture p82: CAD file, 2026-09-05]
Arm_URDF_Files/Assembly.SLDASM
joint 1 - simplified.step
joint 2.step
eBom-FreeParts.step
Part12^Assembly
gear1.step
Base^Assembly
