Yousuf-Eslam/HELAL73_Robot/(list of files, cad)

Other CAD files:
3D_Printing_Files/STL Pack 1/Car Body.stl
3D_Printing_Files/Car Body.step
3D_Printing_Files/STL Pack 1/Joint 2.stl
3D_Printing_Files/Joints/Joint 1 Cover.step
3D_Printing_Files/STL Pack 2/Part 4 - Base Cover.stl
3D_Printing_Files/Exports 9-5/Gear2.stl
3D_Printing_Files/Joints/Joint 2 Cover.step
3D_Printing_Files/Exports 9-5/Finger.stl
3D_Printing_Files/Joints/Joint 1 cover.Stl.stp
3D_Printing_Files/STL Pack 2/Part 1 - Arm Container.stl
3D_Printing_Files/Joints/Joint 1 Bracket.step
3D_Printing_Files/Exports 18-4/Rover Cover(Black).stl
3D_Printing_Files/Joints/Joint 2.stl
3D_Printing_Files/Car Body.stl
3D_Printing_Files/Joints/Joint 1 Body.stl
3D_Printing_Files/Joints/Joint 3 Body.stl
3D_Printing_Files/Mecanum Coupler.f3d
3D_Printing_Files/block.ipt
Arm_URDF_Files/Beta_V2/Assembly.SLDASM/meshes/Gripper_Mechanism.STL
Arm_URDF_Files/Beta_V2/Assembly.SLDASM/meshes/Joint_1.STL
Arm_URDF_Files/Beta_V2/Assembly.SLDASM/meshes/Joint_2.STL
Arm_URDF_Files/Beta_V2/Assembly.SLDASM/meshes/Joint_3.STL
Arm_URDF_Files/Beta_V2/Assembly.SLDASM/meshes/Wrist_Joint.STL
Arm_URDF_Files/Beta_V2/Assembly.SLDASM/meshes/base_link.STL
Arm_URDF_Files/Beta_V2/Assembly.SLDASM/urdf/meshes/Gripper_Mechanism.STL
Arm_URDF_Files/Beta_V2/Assembly.SLDASM/urdf/meshes/Joint_1.STL
Arm_URDF_Files/Beta_V2/Assembly.SLDASM/urdf/meshes/Joint_2.STL
Arm_URDF_Files/Beta_V2/Assembly.SLDASM/urdf/meshes/Joint_3.STL
Arm_URDF_Files/Beta_V2/Assembly.SLDASM/urdf/meshes/Wrist_Joint.STL
Arm_URDF_Files/Beta_V2/Assembly.SLDASM/urdf/meshes/base_link.STL
Arm_URDF_Files/Beta_V3/Assembly.SLDASM/meshes/Gripper_Mechanism.STL
Arm_URDF_Files/Beta_V3/Assembly.SLDASM/meshes/Joint_1.STL
Arm_URDF_Files/Beta_V3/Assembly.SLDASM/meshes/Joint_2.STL
Arm_URDF_Files/Beta_V3/Assembly.SLDASM/meshes/Joint_3.STL
Arm_URDF_Files/Beta_V3/Assembly.SLDASM/meshes/Wrist_Joint.STL
Arm_URDF_Files/Beta_V3/Assembly.SLDASM/meshes/base_link.STL
Arm_URDF_Files/Beta_V3/Assembly.SLDASM/urdf/meshes/Gripper_Mechanism.STL
Arm_URDF_Files/Beta_V3/Assembly.SLDASM/urdf/meshes/Joint_1.STL
Arm_URDF_Files/Beta_V3/Assembly.SLDASM/urdf/meshes/Joint_2.STL
Arm_URDF_Files/Beta_V3/Assembly.SLDASM/urdf/meshes/Joint_3.STL
Arm_URDF_Files/Beta_V3/Assembly.SLDASM/urdf/meshes/Wrist_Joint.STL
Arm_URDF_Files/Beta_V3/Assembly.SLDASM/urdf/meshes/base_link.STL
Arm_URDF_Files/Beta_V4/Assembly.SLDASM/meshes/Link_1.STL
Arm_URDF_Files/Beta_V4/Assembly.SLDASM/meshes/Link_2.STL
Arm_URDF_Files/Beta_V4/Assembly.SLDASM/meshes/Link_3.STL
Arm_URDF_Files/Beta_V4/Assembly.SLDASM/meshes/Link_4.STL
Arm_URDF_Files/Beta_V4/Assembly.SLDASM/meshes/base_link.STL
Arm_URDF_Files/Beta_V4/Assembly.SLDASM/urdf/meshes/Link_1.STL
Arm_URDF_Files/Beta_V4/Assembly.SLDASM/urdf/meshes/Link_2.STL
Arm_URDF_Files/Beta_V4/Assembly.SLDASM/urdf/meshes/Link_3.STL
Arm_URDF_Files/Beta_V4/Assembly.SLDASM/urdf/meshes/Link_4.STL
Arm_URDF_Files/Beta_V4/Assembly.SLDASM/urdf/meshes/base_link.STL
Arm_URDF_Files/Beta_V5/Assembly.SLDASM/meshes/Link_1.STL
Arm_URDF_Files/Beta_V5/Assembly.SLDASM/meshes/Link_2.STL
Arm_URDF_Files/Beta_V5/Assembly.SLDASM/meshes/Link_3.STL
Arm_URDF_Files/Beta_V5/Assembly.SLDASM/meshes/Link_4.STL
Arm_URDF_Files/Beta_V5/Assembly.SLDASM/urdf/meshes/Link_1.STL
Arm_URDF_Files/Beta_V5/Assembly.SLDASM/urdf/meshes/Link_2.STL
Arm_URDF_Files/Beta_V5/Assembly.SLDASM/urdf/meshes/Link_3.STL
Arm_URDF_Files/Beta_V5/Assembly.SLDASM/urdf/meshes/Link_4.STL
Arm_URDF_Files/Beta_V6/Assembly.SLDASM/meshes/Link_1.STL
Arm_URDF_Files/Beta_V6/Assembly.SLDASM/meshes/Link_2.STL
Arm_URDF_Files/Beta_V6/Assembly.SLDASM/meshes/Link_3.STL
Arm_URDF_Files/Beta_V6/Assembly.SLDASM/meshes/Link_4.STL
Arm_URDF_Files/Beta_V6/Assembly.SLDASM/meshes/base_link.STL
Arm_URDF_Files/Beta_V6/Assembly.SLDASM/urdf/meshes/Link_1.STL
Arm_URDF_Files/Beta_V6/Assembly.SLDASM/urdf/meshes/Link_2.STL
Arm_URDF_Files/Beta_V6/Assembly.SLDASM/urdf/meshes/Link_3.STL
Arm_URDF_Files/Beta_V6/Assembly.SLDASM/urdf/meshes/Link_4.STL
Arm_URDF_Files/Beta_V6/Assembly.SLDASM/urdf/meshes/base_link.STL
