Yousuf-Eslam/HELAL73_Robot/Arm_URDF_Files/Beta_V3/Assembly.SLDASM/urdf/BetaV2.urdf

<?xml version="1.0" encoding="utf-8"?>
<!-- This URDF was automatically created by SolidWorks to URDF Exporter! Originally created by Stephen Brawner (brawner@gmail.com) 
     Commit Version: 1.6.0-4-g7f85cfe  Build Version: 1.6.7995.38578
     For more information, please see http://wiki.ros.org/sw_urdf_exporter -->
<robot name="Assembly.SLDASM">
  <link name="base_link">
    <inertial>
      <origin xyz="0.59467 0.81201 1.311" rpy="0 0 0" />
      <mass value="0.20106" />
      <inertia ixx="0.00032337" ixy="-3.0943E-19" ixz="-3.4728E-20" iyy="0.0006434" iyz="1.0638E-18" izz="0.00032337" />
    </inertial>
    <visual>
      <origin xyz="0 0 0" rpy="0 0 0" />
      <geometry>
        <mesh filename="meshes/base_link.STL" />
      </geometry>
      <material name="">
        <color rgba="0.79216 0.81961 0.93333 1" />
      </material>
    </visual>
    <collision>
      <origin xyz="0 0 0" rpy="0 0 0" />
      <geometry>
        <mesh filename="meshes/base_link.STL" />
      </geometry>
    </collision>
  </link>
  <link name="Joint_1">
    <inertial>
      <origin xyz="0.013931 0.032196 0.00026755" rpy="0 0 0" />
      <mass value="0.25173" />
      <inertia ixx="0.00037252" ixy="-7.5458E-05" ixz="-7.0899E-07" iyy="0.00037014" iyz="-1.296E-06" izz="0.00032283" />
    </inertial>
    <visual>
      <origin xyz="0 0 0" rpy="0 0 0" />
      <geometry>
        <mesh filename="meshes/Joint_1.STL" />
      </geometry>
      <material name="">
        <color rgba="0.25098 0.25098 0.25098 1" />
      </material>
    </visual>
    <collision>
      <origin xyz="0 0 0" rpy="0 0 0" />
      <geometry>
        <mesh filename="meshes/Joint_1.STL" />
      </geometry>
    </collision>
  </link>
  <joint name="Joint_1" type="revolute">
    <origin xyz="0.59467 -1.311 0.81701" rpy="1.5708 0 -0.73072" />
    <parent link="base_link" />
    <child link="Joint_1" />
    <axis xyz="0 1 0" />
    <limit lower="-1.5708" upper="1.5708" effort="10" velocity="1" />
  </joint>
  <link name="Joint_2">
    <inertial>
      <origin xyz="-0.065 0.0021095 -1.5105E-07" rpy="0 0 0" />
      <mass value="0.12825" />
      <inertia ixx="3.1366E-05" ixy="-1.199E-11" ixz="3.2943E-11" iyy="0.00033268" iyz="2.323E-10" izz="0.00031027" />
    </inertial>
    <visual>
      <origin xyz="0 0 0" rpy="0 0 0" />
      <geometry>
        <mesh filename="meshes/Joint_2.STL" />
      </geometry>
      <material name="">
        <color rgba="0.25098 0.25098 0.25098 1" />
      </material>
    </visual>
    <collision>
      <origin xyz="0 0 0" rpy="0 0 0" />
      <geometry>
        <mesh filename="meshes/Joint_2.STL" />
      </geometry>
    </collision>
  </link>
  <joint name="Joint_2" type="revolute">
    <origin xyz="0 0.05 0" rpy="3.1416 -0.22804 -1.5708" />
    <parent link="Joint_1" />
    <child link="Joint_2" />
    <axis xyz="0 1 0" />
    <limit lower="-1.5708" upper="1.5708" effort="10" velocity="1" />
  </joint>
  <link name="Joint_3">
    <inertial>
      <origin xyz="0.038371 -1.2821E-05 -0.054604" rpy="0 0 0" />
      <mass value="0.17573" />
      <inertia ixx="0.00042327" ixy="-7.7642E-08" ixz="-7.3921E-08" iyy="0.00042384" iyz="2.0994E-07" izz="9.0533E-05" />
    </inertial>
    <visual>
      <origin xyz="0 0 0" rpy="0 0 0" />
      <geometry>
        <mesh filename="meshes/Joint_3.STL" />
      </geometry>
      <material name="">
        <color rgba="0.79216 0.81961 0.93333 1" />
      </material>
    </visual>
    <collision>
      <origin xyz="0 0 0" rpy="0 0 0" />
      <geometry>
        <mesh filename="meshes/Joint_3.STL" />
      </geometry>
    </collision>
  </link>
  <joint name="Joint_3" type="revolute">
    <origin xyz="-0.13 0 0" rpy="-1.5338 0 -1.5708" />
    <parent link="Joint_2" />
    <child link="Joint_3" />
    <axis xyz="1 0 0" />
    <limit lower="-1.5708" upper="1.5708" effort="10" velocity="1" />
  </joint>
  <link name="Wrist_Joint">
    <inertial>
      <origin xyz="0.0599348461098309 0.0981898770300264 -0.163045826672887" rpy="0 0 0" />
      <mass value="0.0334262148386834" />
      <inertia ixx="2.73150433272108E-05" ixy="-2.2965206080393E-06" ixz="4.52370431674856E-06" iyy="4.74846109616715E-05" iyz="3.15894482005253E-06" izz="2.57181983869544E-05" />
    </inertial>
    <visual>
      <origin xyz="0 0 0" rpy="0 0 0" />
      <geometry>
        <mesh filename="meshes/Wrist_Joint.STL" />
      </geometry>
      <material name="">
        <color rgba="1 1 1 1" />
      </material>
    </visual>
    <collision>
      <origin xyz="0 0 0" rpy="0 0 0" />
      <geometry>
        <mesh filename="meshes/Wrist_Joint.STL" />
      </geometry>
    </collision>
  </link>
  <joint name="Wrist_Joint" type="revolute">
    <origin xyz="-0.057807 0 0" rpy="0 0.53715 -1.9725" />
    <parent link="Joint_3" />
    <child link="Wrist_Joint" />
    <axis xyz="0.33591 -0.9204 0.20005" />
    <limit lower="-1.5708" upper="1.5708" effort="10" velocity="1" />
  </joint>
  <link name="Gripper_Mechanism">
    <inertial>
      <origin xyz="0.0599348461098308 0.0981898770300262 -0.163045826672887" rpy="0 0 0" />
      <mass value="0.0334262148386834" />
      <inertia ixx="2.73150433272108E-05" ixy="-2.2965206080393E-06" ixz="4.52370431674856E-06" iyy="4.74846109616715E-05" iyz="3.15894482005253E-06" izz="2.57181983869544E-05" />
    </inertial>
    <visual>
      <origin xyz="0 0 0" rpy="0 0 0" />
      <geometry>
        <mesh filename="meshes/Gripper_Mechanism.STL" />
      </geometry>
      <material name="">
        <color rgba="1 1 1 1" />
      </material>
    </visual>
    <collision>
      <origin xyz="0 0 0" rpy="0 0 0" />
      <geometry>
        <mesh filename="meshes/Gripper_Mechanism.STL" />
      </geometry>
    </collision>
  </link>
  <joint name="Gripper_Mechanism" type="revolute">
    <origin xyz="0 0 0" rpy="0 0 0" />
    <parent link="Wrist_Joint" />
    <child link="Gripper_Mechanism" />
    <axis xyz="0.33591 -0.9204 0.20005" />
    <limit lower="-1.5708" upper="1.5708" effort="10" velocity="1" />
  </joint>
</robot>
