Yousuf-Eslam/HELAL73_Robot/Arm_URDF_Files/Beta_V5/Assembly.SLDASM/urdf/Assembly_v2.urdf

<?xml version="1.0" encoding="utf-8"?>
<robot name="Assembly.SLDASM">

  <link name="base_link">
    <inertial>
      <origin xyz="-2.22044604925031E-16 0.00500000000000023 -0.00499999999999767" rpy="0 0 0" />
      <mass value="0.201061929829747" />
      <inertia ixx="0.000323374603809509" ixy="-3.09432309375888E-19" ixz="-3.47283508374262E-20" iyy="0.000643398175455189" iyz="1.06382106690128E-18" izz="0.000323374603809509" />
    </inertial>
    <visual>
      <origin xyz="0 0 0" rpy="0 0 0" />
      <geometry>
        <mesh filename="G:\My Drive\الكلية\Junior\Mechatronics Design\HILAL Project\Mechanical Design\HILAL Arm URDF File\Beta_V5\Assembly.SLDASM\urdf\meshes\base_link.STL" />
      </geometry>
      <material name="">
        <color rgba="0.792156862745098 0.819607843137255 0.933333333333333 1" />
      </material>
    </visual>
    <collision>
      <origin xyz="0 0 0" rpy="0 0 0" />
      <geometry>
        <mesh filename="G:\My Drive\الكلية\Junior\Mechatronics Design\HILAL Project\Mechanical Design\HILAL Arm URDF File\Beta_V5\Assembly.SLDASM\urdf\meshes\base_link.STL" />
      </geometry>
    </collision>
  </link>

  <link name="Link_1">
    <inertial>
      <origin xyz="0.00893053095799878 -0.0501964237022623 -0.000267555465881752" rpy="0 0 0" />
      <mass value="0.256765494419994" />
      <inertia ixx="0.00037997097567768" ixy="7.69676163119527E-05" ixz="7.23177242972426E-07" iyy="0.000377544614662834" iyz="-1.32193832728184E-06" izz="0.000329283641030161" />
    </inertial>
    <visual>
      <origin xyz="0 0 0" rpy="0 0 0" />
      <geometry>
        <mesh filename="G:\My Drive\الكلية\Junior\Mechatronics Design\HILAL Project\Mechanical Design\HILAL Arm URDF File\Beta_V5\Assembly.SLDASM\urdf\meshes\Link_1.STL" />
      </geometry>
      <material name="">
        <color rgba="1 1 1 1" />
      </material>
    </visual>
    <collision>
      <origin xyz="0 0 0" rpy="0 0 0" />
      <geometry>
        <mesh filename="G:\My Drive\الكلية\Junior\Mechatronics Design\HILAL Project\Mechanical Design\HILAL Arm URDF File\Beta_V5\Assembly.SLDASM\urdf\meshes\Link_1.STL" />
      </geometry>
    </collision>
  </link>

  <joint name="Joint_1" type="revolute">
    <origin xyz="0 -0.008 0" rpy="0 -1.5708 0" />
    <parent link="base_link" />
    <child link="Link_1" />
    <axis xyz="0 0 1" />
    <limit lower="-1.5708" upper="1.5708" effort="10" velocity="1.0" />
  </joint>

  <link name="Link_2">
    <inertial>
      <origin xyz="0.0650000226690595 0.0101094971645044 -1.40136940163238E-07" rpy="0 0 0" />
      <mass value="0.13081346914469" />
      <inertia ixx="3.19933477457961E-05" ixy="-1.63965381589991E-11" ixz="3.69281468684547E-11" iyy="0.000339337197206022" iyz="2.35582270088809E-10" izz="0.000316470986061007" />
    </inertial>
    <visual>
      <origin xyz="0 0 0" rpy="0 0 0" />
      <geometry>
        <mesh filename="G:\My Drive\الكلية\Junior\Mechatronics Design\HILAL Project\Mechanical Design\HILAL Arm URDF File\Beta_V5\Assembly.SLDASM\urdf\meshes\Link_2.STL" />
      </geometry>
      <material name="">
        <color rgba="1 1 1 1" />
      </material>
    </visual>
    <collision>
      <origin xyz="0 0 0" rpy="0 0 0" />
      <geometry>
        <mesh filename="G:\My Drive\الكلية\Junior\Mechatronics Design\HILAL Project\Mechanical Design\HILAL Arm URDF File\Beta_V5\Assembly.SLDASM\urdf\meshes\Link_2.STL" />
      </geometry>
    </collision>
  </link>

  <joint name="Joint_2" type="revolute">
    <origin xyz="0.003 -0.068 0.13" rpy="1.5708 1.5708 0" />
    <parent link="Link_1" />
    <child link="Link_2" />
    <axis xyz="0 0 1" />
    <limit lower="-1.5708" upper="1.5708" effort="10" velocity="1.0" />
  </joint>

  <link name="Link_3">
    <inertial>
      <origin xyz="0.0303712683102628 -1.28257179500268E-05 -0.0546040464940484" rpy="0 0 0" />
      <mass value="0.17924252226062" />
      <inertia ixx="0.000431735729782239" ixy="-7.91912037492762E-08" ixz="-7.53992425536981E-08" iyy="0.000432319012881455" iyz="2.1412123442373E-07" izz="9.23438538779845E-05" />
    </inertial>
    <visual>
      <origin xyz="0 0 0" rpy="0 0 0" />
      <geometry>
        <mesh filename="G:\My Drive\الكلية\Junior\Mechatronics Design\HILAL Project\Mechanical Design\HILAL Arm URDF File\Beta_V5\Assembly.SLDASM\urdf\meshes\Link_3.STL" />
      </geometry>
      <material name="">
        <color rgba="1 1 1 1" />
      </material>
    </visual>
    <collision>
      <origin xyz="0 0 0" rpy="0 0 0" />
      <geometry>
        <mesh filename="G:\My Drive\الكلية\Junior\Mechatronics Design\HILAL Project\Mechanical Design\HILAL Arm URDF File\Beta_V5\Assembly.SLDASM\urdf\meshes\Link_3.STL" />
      </geometry>
    </collision>
  </link>

  <joint name="Joint_3" type="revolute">
    <origin xyz="0 0 0" rpy="0 0 -1.5708" />
    <parent link="Link_2" />
    <child link="Link_3" />
    <axis xyz="0 0 1" />
    <limit lower="-1.5708" upper="1.5708" effort="10" velocity="1.0" />
  </joint>

  <link name="Link_4">
    <inertial>
      <origin xyz="-0.0197285071096552 -0.00504137959761697 -0.0135890586703304" rpy="0 0 0" />
      <mass value="0.0340947397477868" />
      <inertia ixx="2.78616725279663E-05" ixy="-2.34226081006019E-06" ixz="4.61088384137761E-06" iyy="4.84174561974037E-05" iyz="3.22212872617662E-06" izz="2.62153451954576E-05" />
    </inertial>
    <visual>
      <origin xyz="0 0 0" rpy="0 0 0" />
      <geometry>
        <mesh filename="G:\My Drive\الكلية\Junior\Mechatronics Design\HILAL Project\Mechanical Design\HILAL Arm URDF File\Beta_V5\Assembly.SLDASM\urdf\meshes\Link_4.STL" />
      </geometry>
      <material name="">
        <color rgba="1 1 1 1" />
      </material>
    </visual>
    <collision>
      <origin xyz="0 0 0" rpy="0 0 0" />
      <geometry>
        <mesh filename="G:\My Drive\الكلية\Junior\Mechatronics Design\HILAL Project\Mechanical Design\HILAL Arm URDF File\Beta_V5\Assembly.SLDASM\urdf\meshes\Link_4.STL" />
      </geometry>
    </collision>
  </link>

  <joint name="Joint_4" type="revolute">
    <origin xyz="0.0067669 -0.01531 -0.17117" rpy="0 0.53715 -3.1416" />
    <parent link="Link_3" />
    <child link="Link_4" />
    <axis xyz="0 0 1" />
    <limit lower="-1.5708" upper="1.5708" effort="10" velocity="1.0" />
  </joint>

</robot>
